Elektronika-u-Petnici/DC_load/README.md

# DC load

Petničko linearno opterećenje

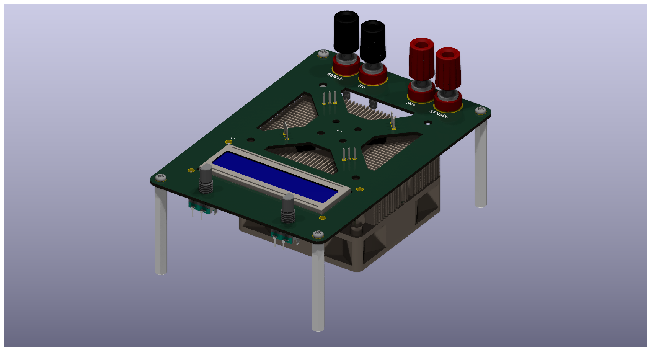
[picture p1: DC_load.png]
plot
