Elektronika-u-Petnici/DC_load/simulacije/UART_isolation.asc

C1: cap; 10µ
C2: cap; 100n
C3: cap; 10µ
C4: cap; 10µ
C5: cap; 100n
C6: cap; 10µ
C7: cap; 100n
C8: cap; 10µ
C9: cap; 10µ
C10: cap; 10µ
C11: cap; 10n
C12: cap; 10n
C13: cap; 10n
C14: cap; 10n
C15: cap; 10n
C16: cap; 10n
C17: cap; 10n
C18: cap; 10n
C19: cap; 1n
C20: cap; 10n
C21: cap; 1n
C22: cap; 10n
C23: cap; 1n
C24: cap; 10n
C25: cap; 1n
D1: diode; 1N4148
D2: diode; 1N4148
D3: diode; 1N4148
D4: diode; 1N4148
D5: diode; 1N4148
D6: diode; 1N4148
D7: diode; 1N4148
D8: diode; 1N4148
D9: diode; 1N4148
D10: diode; 1N4148
D11: diode; 1N4148
D12: diode; 1N4148
D13: diode; 1N4148
D14: diode; 1N4148
D15: diode; 1N4148
D16: diode; 1N4148
D17: diode; 1N4148
D18: diode; 1N4148
D19: diode; 1N4148
D20: diode; 1N4148
D21: diode; 1N4148
D22: diode; 1N4148
D23: diode; BAV99HM
D24: diode; BAV99HM
D25: diode; BAV99HM
D26: diode; BAV99HM
D27: diode; BAV99HM
D28: diode; BAV99HM
D29: diode; BAV99HM
D30: diode; BAV99HM
D31: diode; BAV99HM
D32: diode; BAV99HM
D33: diode; BAV99HM
D34: diode; 1N4148
D35: diode; BAV99HM
D36: diode; BAV99HM
D37: diode; BAV99HM
D38: diode; BAV99HM
D39: diode; BAV99HM
D40: diode; BAV99HM
D41: diode; BAV99HM
D42: diode; BAV99HM
D43: diode; BAV99HM
D44: diode; BAV99HM
D45: diode; BAV99HM
D46: diode; BAV99HM
D47: diode; BAV99HM
D48: diode; BAV99HM
D49: diode; BAV99HM
D50: diode; BAV99HM
D51: diode; BAV99HM
D52: diode; BAV99HM
D53: diode; BAV99HM
D54: diode; BAV99HM
D55: diode; BAV99HM
D56: diode; BAV99HM
D57: diode; BAV99HM
D58: diode; BAV99HM
D59: diode; BAV99HM
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
U23: PC817A
V1: voltage; 3.3V
V2: voltage; 12
V3: voltage; 5
V4: voltage; -5
V5: voltage; 24
V10: voltage; PULSE(5 0 0 10n 10n {0.5 / fsw} {1 / fsw})
Named nets: 12V, 0, 24V, 3V3, input, 5V, fault, TTL_OUT, output, output_3V3
.tran 0 55u 50u
.param vcc = 3.3
.param rin 1k
.param fsw = 115200 * 10
