Elektronika-u-Petnici/DC_load/simulacije/self_flyback_v5.asc

C1: cap; 100µ
C2: cap; 47n
C3: cap; 5µ
C4: cap; 4.7n
D1: schottky; 1N5819
D2: schottky; 1N5819
D3: schottky; 1N5819
D5: schottky; 1N5819
L1: ind2; {Lm}
L2: ind2; {Lm}
L3: ind2; {Lm}
L4: ind2; {Lm}
L5: ind; 100µ
Q1: npn; 2N5551
Q2: npn; 2N5551
Q3: npn; 2N5551
Q4: npn; 2N5551
Q5: npn; 2N5551
R1: res; 10k
R2: res; 100
R3: res; 10k
R4: res; 1k
R5: res; 1k
R6: res; {Rload}
R7: res; 100m
R8: res; 15k
R9: res; 2k
V1: voltage; 5
Named nets: 0, c
.tran 0 10000m 0 100n uic
K1 L1 L2 L3 L4 0.99
.param K = 1 Lm = 100u
.param Rload = 1000
