Elektronika-u-Petnici/DC_load/simulacije/DC_fan_isolator.asc

C1: cap; 1µ
C2: cap; 1µ
C3: cap; 1µ
I1: current; 500µ
I2: current; 1m
I3: current; 6m
Q1: npn; 2N3904
Q2: npn; 2N3904
Q3: npn; 2N3904
Q4: npn; 2N3904
Q5: npn; 2N3904
Q6: npn; 2N3904
Q7: pnp; 2N3906
Q8: pnp; 2N3906
Q9: npn; 2N3904
Q10: npn; 2N3904
Q11: npn; 2N5551
R1: res; 1k
R2: res; 100
R3: res; 100
R4: res; 1k
R5: res; 40k
R6: res; 33k
R7: res; 81k
R8: res; 22k
R9: res; 51k
R10: res; 10k
R11: res; 1k
R12: res; 510k
R13: res; 100k
R14: res; 1k
R15: res; 1k
R16: res; 100k
R17: res; 100k
R18: res; 1k
R19: res; 1m
R20: res; 10k
R21: res; 1m
R22: res; 30
R23: res; 1k
R24: res; 40k
R25: res; 10k
R26: res; 1m
R27: res; 10k
R28: res; 1k
R29: res; 300
U3: PC817A
V1: voltage; {Vbat}
V2: voltage; {Vbat}
V3: voltage; {Vbat}
V4: voltage; {Vbat}
V5: voltage; {Vbat}
V6: voltage; {Vbat}
V7: voltage; 12
V8: voltage; PULSE(5 0 0 10n 10n {0.5 / 30k} {1 / 30k})
Named nets: 0, vout+, input
.param fsw = 40k
.param d = 0.5
.param Cf = 10u
.tran 10m
.lib AO3400.mod
.step param Vbat list 3.5 3.9 4.2
