Elektronika-u-Petnici/DC_load/simulacije/inverter_PWM.asc

C1: cap; 100p
D1: diode; 1N4148
R2: res; 1Meg
R3: res; 100k
R6: res; 33k
U2: SN74HC14
V5: voltage; 3.6
Named nets: 0, out
.param fsw = 40k
.param d = 0.5
.param Cf = 10u
.tran 0 1m 0 1n uic
.ic V(out) = 3.6
