Elektronika-u-Petnici/DC_load/simulacije/gate_drive_v2.asc

C1: cap; 22µ
C2: cap; 22µ
C3: cap; 1n
C4: cap; 22µ
Q1: npn; 2N5550
Q2: pnp; 2N5401
Q3: npn; 2N5550
Q4: npn; 2N5550
Q5: pnp; 2N5401
Q6: npn; 2N5550
R1: res; 10m
R2: res; 10
R3: res; 10
R7: res; 1k
R8: res; 10m
R9: res; 1k
R14: res; 1k
R15: res; 1k
V1: voltage; 12
V2: voltage; PULSE(0 5 0 10n 10n {d / fsw} {1 / fsw})
V3: voltage; 5
V4: voltage; PULSE(0 5 {0.5 / fsw} 10n 10n {d / fsw} {1 / fsw})
Named nets: 0, G2, 5V, vin
.tran 10u uic
.param fsw = 200k
.param d = 0.5
.param Rload = 50
.param Lprim = 200u Lsec=200u
;tran 2m uic
