Elektronika-u-Petnici/DC_load/simulacije/half_bridge_pwm_gen_V3.asc

C5: cap; 100p
C6: cap; 100p
D3: schottky; 1N5819
D4: diode; 1N4148
D6: diode; 1N4148
Q1: npn; 2N5551
Q2: pnp; 2N5401
Q3: npn; 2N5551
R7: res; 1k
R9: res; 1k
R15: res; 1k
R16: res; 1k
U1: SN74HC14
U2: SN74HC14
U3: SN74HC14
U4: SN74HC14
U5: SN74HC14
V1: voltage; 12
V2: voltage; PULSE(0 12 0u 10n 10n {d / fsw} {1 / fsw})
V3: voltage; 5
Named nets: 0, G2, vin, 5V, G1
;tran 2m
.param fsw = 200k
.param d = 0.45
.param Rload = 50
.param Lprim = 200u Lsec=200u
.tran 2m uic
