Elektronika-u-Petnici/DC_load/simulacije/intentionally_disbalanced_half_bridge.asc

B1: bv; V= if(time >  start_time, idt(V(vout)*I(R30))/(time - start_time),0)
B2: bv; V=if(time > start_time, -idt(V(vin)*I(V1)) / (time - start_time),0)
B3: bv; V= min(max(V(output_power) / V(input_power),0), 1)
B4: bv; V=  V(input_power) - V(output_power)
C1: cap; 22µ
C2: cap; 22µ
C3: cap; 22µ
C4: cap; 22µ
C5: cap; 22µ
D1: schottky; 1N5819
D2: schottky; 1N5819
D3: schottky; 1N5819
L1: ind2; {Lprim}
L2: ind2; {Lsec}
L3: ind2; {Lprim}
L4: ind2; {Lsec}
L5: ind; 1µ
M1: nmos; AO6608_N
M2: nmos; AO6608_N
Q1: npn; 2N5551
Q2: pnp; 2N5401
Q3: npn; 2N5551
R1: res; 10m
R2: res; 10
R3: res; 10
R4: res; 1m
R5: res; 1m
R6: res; 10m
R7: res; 1k
R8: res; 10m
R9: res; 1k
R10: res; 1
R11: res; 1
R12: res; 1
R13: res; 1
R14: res; 10m
R30: res; 100
V1: voltage; 12
V2: voltage; PULSE(0 12 0.1u 10n 10n {d / fsw - 0.2u} {1 / fsw})
V3: voltage; 5
V4: voltage; PULSE(0 12 0 10n 10n {d / fsw} {1 / fsw})
Named nets: 0, G2, vin, vout, output_power, input_power, efficiency, losses, 5V
;tran 2m
.param fsw = 200k
.param d = 0.25
.param Rload = 50
.param Lprim = 200u Lsec=200u
.tran 2m uic
.param start_time = 1m
K1 L1 L2 L3 L4 0.999
