Elektronika-u-Petnici/DC_load/simulacije/DC_fan_boost.asc

C2: cap; 10µ
D1: schottky; 1N5819
L1: ind; 22µ
M1: nmos; AO4630_N
R1: res; 120
R2: res; 100m
R3: res; 40m
U3: SN74LVC1G08
U4: SN74LVC1G08
V1: voltage; PULSE(0 5 {1 / fsw / 2} 10n 10n {d / fsw} {1 / fsw})
V2: voltage; 310
V3: voltage; PULSE(0 5 10u 10n 10n 1m 10m)
V4: voltage; PULSE(0 12 10u 10n 10n 30u 10m 1)
V5: voltage; 5
Named nets: 0, 5V, input, source, init
.tran 10m
.param fsw = 100k
.param d = 0.3
