Elektronika-u-Petnici/DC_load/simulacije/3.3vzener_gate_drive_amp.asc

C1: cap; 100p
C2: cap; 10µ
D2: diode; BAV99HY
D3: diode; BAV99HY
Q1: pnp; 2N3906
Q2: npn; 2N5551
R1: res; 10k
R2: res; 10m
R3: res; 100
R4: res; 330
R5: res; 10k
R6: res; 100
R7: res; 1k
R8: res; 9k
R9: res; 1k
R10: res; 3k3
R11: res; 10k
U1: TLV9062
U2: opamp2; NCS21802
V1: voltage; 3.3
V2: voltage; 10
V3: voltage; SINE(0.5 0.1 10k)
V4: voltage; PULSE(12 13 0 10n 10n 10u 20u)
X1: n_channel_mosfet
Named nets: 0, 3V3, shunt, 12V
.tran 1m
.lib FQP6N90C.lib
.lib "NCS2180X SPICE MODEL.MOD"
