Elektronika-u-Petnici/DC_load/simulacije/12V_gate_drive.asc

C1: cap; 100p
R1: res; 10k
R2: res; 10m
R3: res; 1k
R4: res; 100
R5: res; 1k
U1: LM358
U2: opamp2; NCS21802
V1: voltage; 12
V2: voltage; 10
V3: voltage; SINE(0.5 0.1 10k)
V4: voltage; 5
X1: n_channel_mosfet
Named nets: 0, 12V, shunt, 5V
.tran 1m
.lib FQP6N90C.lib
.lib "NCS2180X SPICE MODEL.MOD"
