Elektronika-u-Petnici/DC_load/simulacije/ina181.asc

C1: cap; 100p
C3: cap; 100p
C4: cap; 10µ
D1: zener; BZX79C2V7
D5: zener; BZX79C2V7
D6: diode; 1N4148
D7: diode; 1N4148
Q2: pnp; 2N3906
R1: res; 1k
R2: res; 10m
R3: res; 100
R4: res; 9k
R5: res; 1k
R6: res; 2k
R10: res; 1k
R11: res; 10m
R12: res; 100
R13: res; 200
R14: res; 1k
R17: res; 9k
R18: res; 1k
U1: TLV9062
U2: INA181A1
U3: TLV9062
U5: INA181A1
V1: voltage; 5
V2: voltage; 10
V3: voltage; SINE(0.5 0.1 100k)
V4: voltage; 12
V6: voltage; 10
V7: voltage; SINE(0.5 0.1 100k)
X1: n_channel_mosfet
X2: n_channel_mosfet
Named nets: 5V, 0, 12V, shunt
.tran 1m
.lib FQP6N90C.lib
.lib "NCS2180X SPICE MODEL.MOD"
;tran 1m
.lib ina181a1.lib
;tran 1m
