Elektronika-u-Petnici/DC_load/simulacije/ncsc.asc

C3: cap; 100p
D4: zener; BZX79C2V7
R10: res; 10k
R11: res; 10m
R12: res; 100
R13: res; 100
R14: res; 1k
R15: res; 200
R16: res; 1k
R17: res; 9k
R18: res; 1k
U3: TLV9062
U4: opamp2; NCS21802
V1: voltage; 5
V4: voltage; 12
V6: voltage; 10
V7: voltage; SINE(0.5 0.1 100k)
X2: n_channel_mosfet
Named nets: 5V, 0, 12V
.tran 1m
.lib FQP6N90C.lib
.lib "NCS2180X SPICE MODEL.MOD"
;tran 1m
