Elektronika-u-Petnici/DC_load/simulacije/pnp_load.asc

B1: bv; V=100 * V(shunt)
C1: cap; 100p
Q1: npn; 2N3904
Q2: pnp; BD244C
R1: res; 10k
R2: res; 10m
R3: res; 100
R4: res; 100
R5: res; 600
U1: LM358
V1: voltage; 12
V2: voltage; 10
V3: voltage; SINE(0.5 0.1 10k)
V4: voltage; 5
Named nets: 0, 12V, shunt, 5V
.tran 1m
.lib FQP6N90C.lib
.lib "NCS2180X SPICE MODEL.MOD"
