Elektronika-u-Petnici/DC_load/simulacije/zener_gate_drive.asc

B1: bv; V=100 * V(shunt)
C1: cap; 100p
D1: zener; BZX79C2V7
R1: res; 10k
R2: res; 10m
R3: res; 100
R4: res; 10k
U1: TLV9062
V1: voltage; 5
V2: voltage; 10
V3: voltage; SINE(0.5 0.1 10k)
V4: voltage; 12
X1: n_channel_mosfet
Named nets: 0, 5V, shunt, 12V
.tran 1m
.lib FQP6N90C.lib
