Elektronika-u-Petnici/DC_load/simulacije/zener_gate_drive_amp.asc

C1: cap; 100p
C2: cap; 10µ
C3: cap; 100p
D1: zener; BZX79C2V7
D2: diode; 1N4148
D3: diode; 1N4148
D4: zener; BZX79C2V7
Q1: pnp; 2N3906
R1: res; 10k
R2: res; 10m
R3: res; 100
R4: res; 200
R5: res; 1k
R6: res; 100
R7: res; 1k
R8: res; 9k
R9: res; 1k
R10: res; 10k
R11: res; 10m
R12: res; 100
R13: res; 100
R14: res; 1k
R15: res; 200
R16: res; 1k
R17: res; 9k
R18: res; 1k
U1: TLV9062
U2: opamp2; NCS21802
U3: TLV9062
U4: opamp2; NCS21802
V1: voltage; 5
V2: voltage; 10
V3: voltage; SINE(0.5 0.1 10k)
V4: voltage; 12
V6: voltage; 10
V7: voltage; SINE(0.5 0.1 10k)
X1: n_channel_mosfet
X2: n_channel_mosfet
Named nets: 0, 5V, shunt, 12V
.tran 1m
.lib FQP6N90C.lib
.lib "NCS2180X SPICE MODEL.MOD"
;tran 1m
