Elektronika-u-Petnici/DC_load/simulacije/voltage_reference.asc

C1: cap; 10µ
C3: cap; 10µ
C4: cap; 10µ
C6: cap; 100µ
C7: cap; 10µ
C8: cap; 100µ
C9: cap; 10µ
C10: cap; 100µ
D1: diode; 1N4148
D2: diode; 1N4148
I1: current; SINE(2m 1m 200k)
I2: current; SINE(2m 1m 200k)
I3: current; SINE(2m 1m 200k)
Q2: pnp; 2N3906
Q3: npn; 2N3904
R1: res; 1k
R2: res; 200
R3: res; {p}
R4: res; 100k
R5: res; 100k
R6: res; 100k
R7: res; 100k
U1: TL431
U2: TL431
U3: TL431
V1: voltage; SINE(5 1 100k)
Named nets: 0
.tran 5m
.step param p list 2k 5k 10k
