Elektronika-u-Petnici/DC_load/kicad/DC_load_isolation_module/DC_load_isolation_module.kicad_pcb

## KiCad design kicad/DC_load_isolation_module/DC_load_isolation_module.kicad_pcb (2026-01-17)

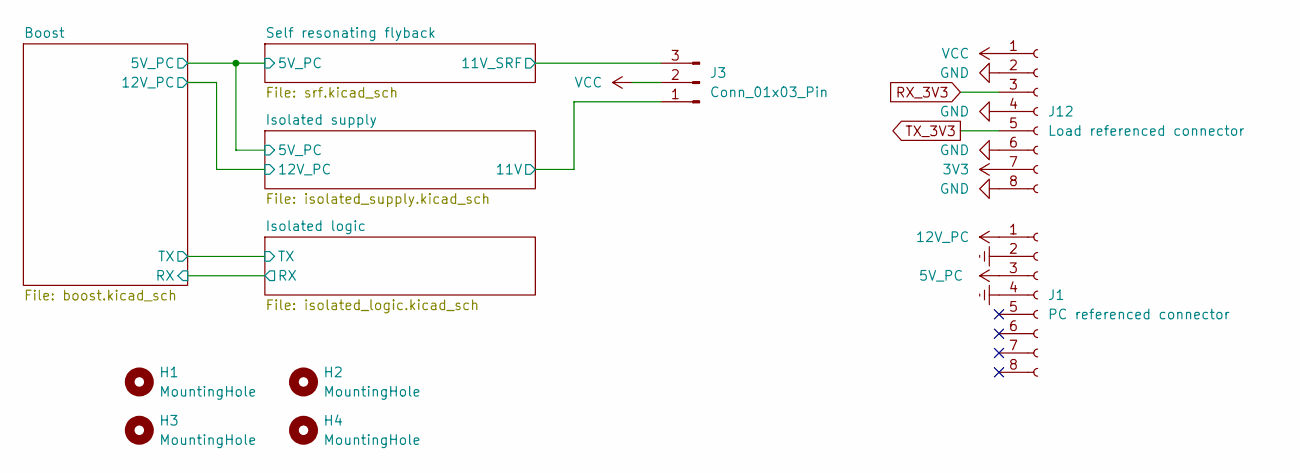
[picture p2: schematic DC_load_isolation_module.kicad_sch, DC load isolation module]

Parts:
H1, H2, H3, H4: MountingHole; M3_hole_with_spacer
J1: PC referenced connector; PinSocket_1x08_P2.54mm_Vertical
J3: Conn_01x03_Pin; PinHeader_1x03_P2.54mm_Vertical
J12: Load referenced connector; PinSocket_1x08_P2.54mm_Vertical

Connections:
3V3: J12.7; also elsewhere on the board
5V_PC: J1.3; also elsewhere on the board
12V_PC: J1.1; also elsewhere on the board
/Isolated supply/11V: J3.1; also elsewhere on the board
/Self resonating flyback/11V_SRF: J3.3; also elsewhere on the board
Earth: J1.2, J1.4; also elsewhere on the board
GND: J12.2, J12.4, J12.6, J12.8; also elsewhere on the board
RX_3V3: J12.3; also elsewhere on the board
TX_3V3: J12.5; also elsewhere on the board
VCC: J3.2, J12.1

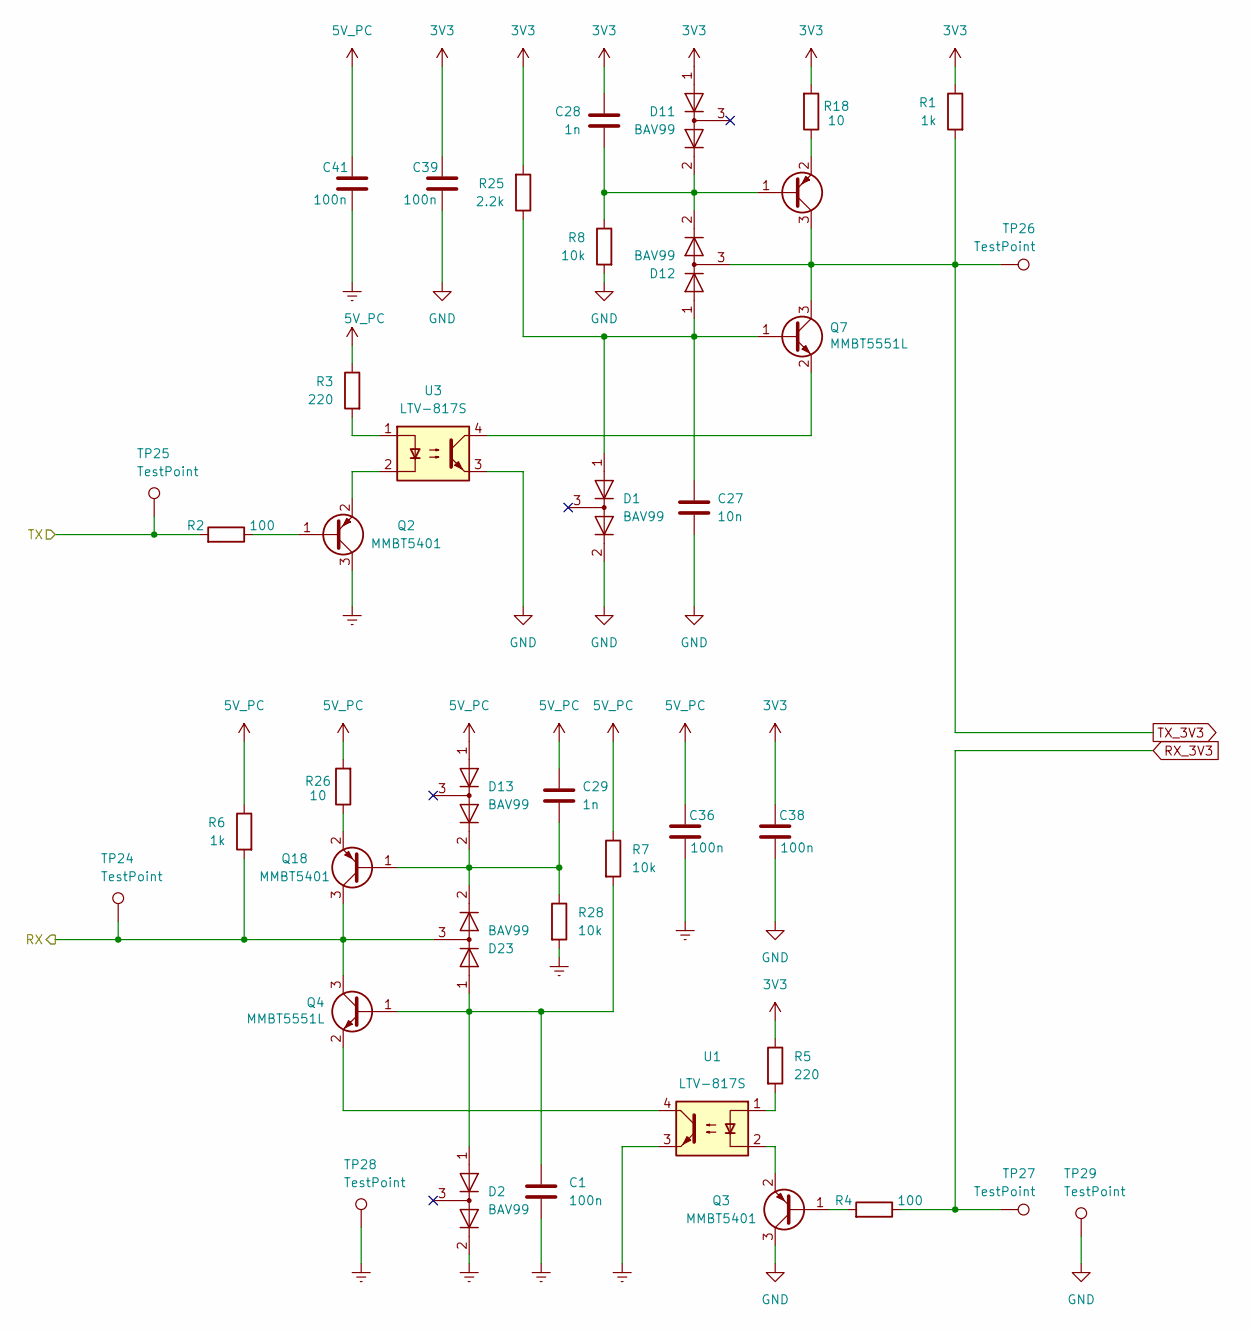
[picture p3: schematic isolated_logic.kicad_sch]

Parts:
C1, C36, C38, C39, C41: 100n; C_0603_1608Metric_Pad1.08x0.95mm_HandSolder; LCSC C14663
C27: 10n; C_0603_1608Metric_Pad1.08x0.95mm_HandSolder; LCSC C57112
C28, C29: 1n; C_0603_1608Metric_Pad1.08x0.95mm_HandSolder; LCSC C1588
D1, D2, D11, D12, D13, D23: BAV99; SOT-23; LCSC C2500
Q2, Q3, Q17, Q18: MMBT5401; SOT-23; LCSC C8326
Q4, Q7: MMBT5551L; SOT-23; LCSC C2145
R1, R6: 1k; R_0603_1608Metric_Pad0.98x0.95mm_HandSolder; LCSC C22962
R2, R4: 100; R_0603_1608Metric_Pad0.98x0.95mm_HandSolder; LCSC C22775
R3, R5: 220; R_0603_1608Metric_Pad0.98x0.95mm_HandSolder; LCSC C22962
R7, R8, R28: 10k; R_0603_1608Metric_Pad0.98x0.95mm_HandSolder; LCSC C25804
R18, R26: 10; R_0603_1608Metric_Pad0.98x0.95mm_HandSolder; LCSC C22859
R25: 2.2k; R_0603_1608Metric_Pad0.98x0.95mm_HandSolder; LCSC C4190
TP24, TP25, TP26, TP27, TP28, TP29: TestPoint; TestPoint_Pad_D2.0mm
U1, U3: LTV-817S; SMDIP-4_W9.53mm

Connections:
3V3: C28.2, C38.1, C39.1, D11.1 (K), R1.1, R5.1, R18.2, R25.2; also elsewhere on the board
5V_PC: C29.2, C36.1, C41.1, D13.1 (K), R3.1, R6.1, R7.1, R26.2; also elsewhere on the board
/Boost/RX: D23.3 (K), Q4.3 (C), Q18.3 (C), R6.2, TP24.1; also elsewhere on the board
/Boost/TX: R2.2, TP25.1; also elsewhere on the board
Earth: C1.1, C36.2, C41.2, D2.2 (A), Q2.3 (C), R28.2, TP28.1, U1.3; also elsewhere on the board
GND: C27.1, C38.2, C39.2, D1.2 (A), Q3.3 (C), R8.2, TP29.1, U3.3; also elsewhere on the board
unnamed: C28.1, D11.2 (A), D12.2 (A), Q17.1 (B), R8.1
unnamed: C29.1, D13.2 (A), D23.2 (A), Q18.1 (B), R28.1
unnamed: Q2.1 (B), R2.1
unnamed: Q2.2 (E), U3.2
unnamed: Q3.1 (B), R4.2
unnamed: Q3.2 (E), U1.2
unnamed: C1.2, D2.1 (K), D23.1 (K), Q4.1 (B), R7.2
unnamed: Q4.2 (E), U1.4
unnamed: C27.2, D1.1 (K), D12.1 (K), Q7.1 (B), R25.1
unnamed: Q7.2 (E), U3.4
unnamed: Q17.2 (E), R18.1
unnamed: Q18.2 (E), R26.1
unnamed: R3.2, U3.1
unnamed: R5.2, U1.1
RX_3V3: R4.1, TP27.1; also elsewhere on the board
TX_3V3: D12.3 (K), Q7.3 (C), Q17.3 (C), R1.2, TP26.1; also elsewhere on the board

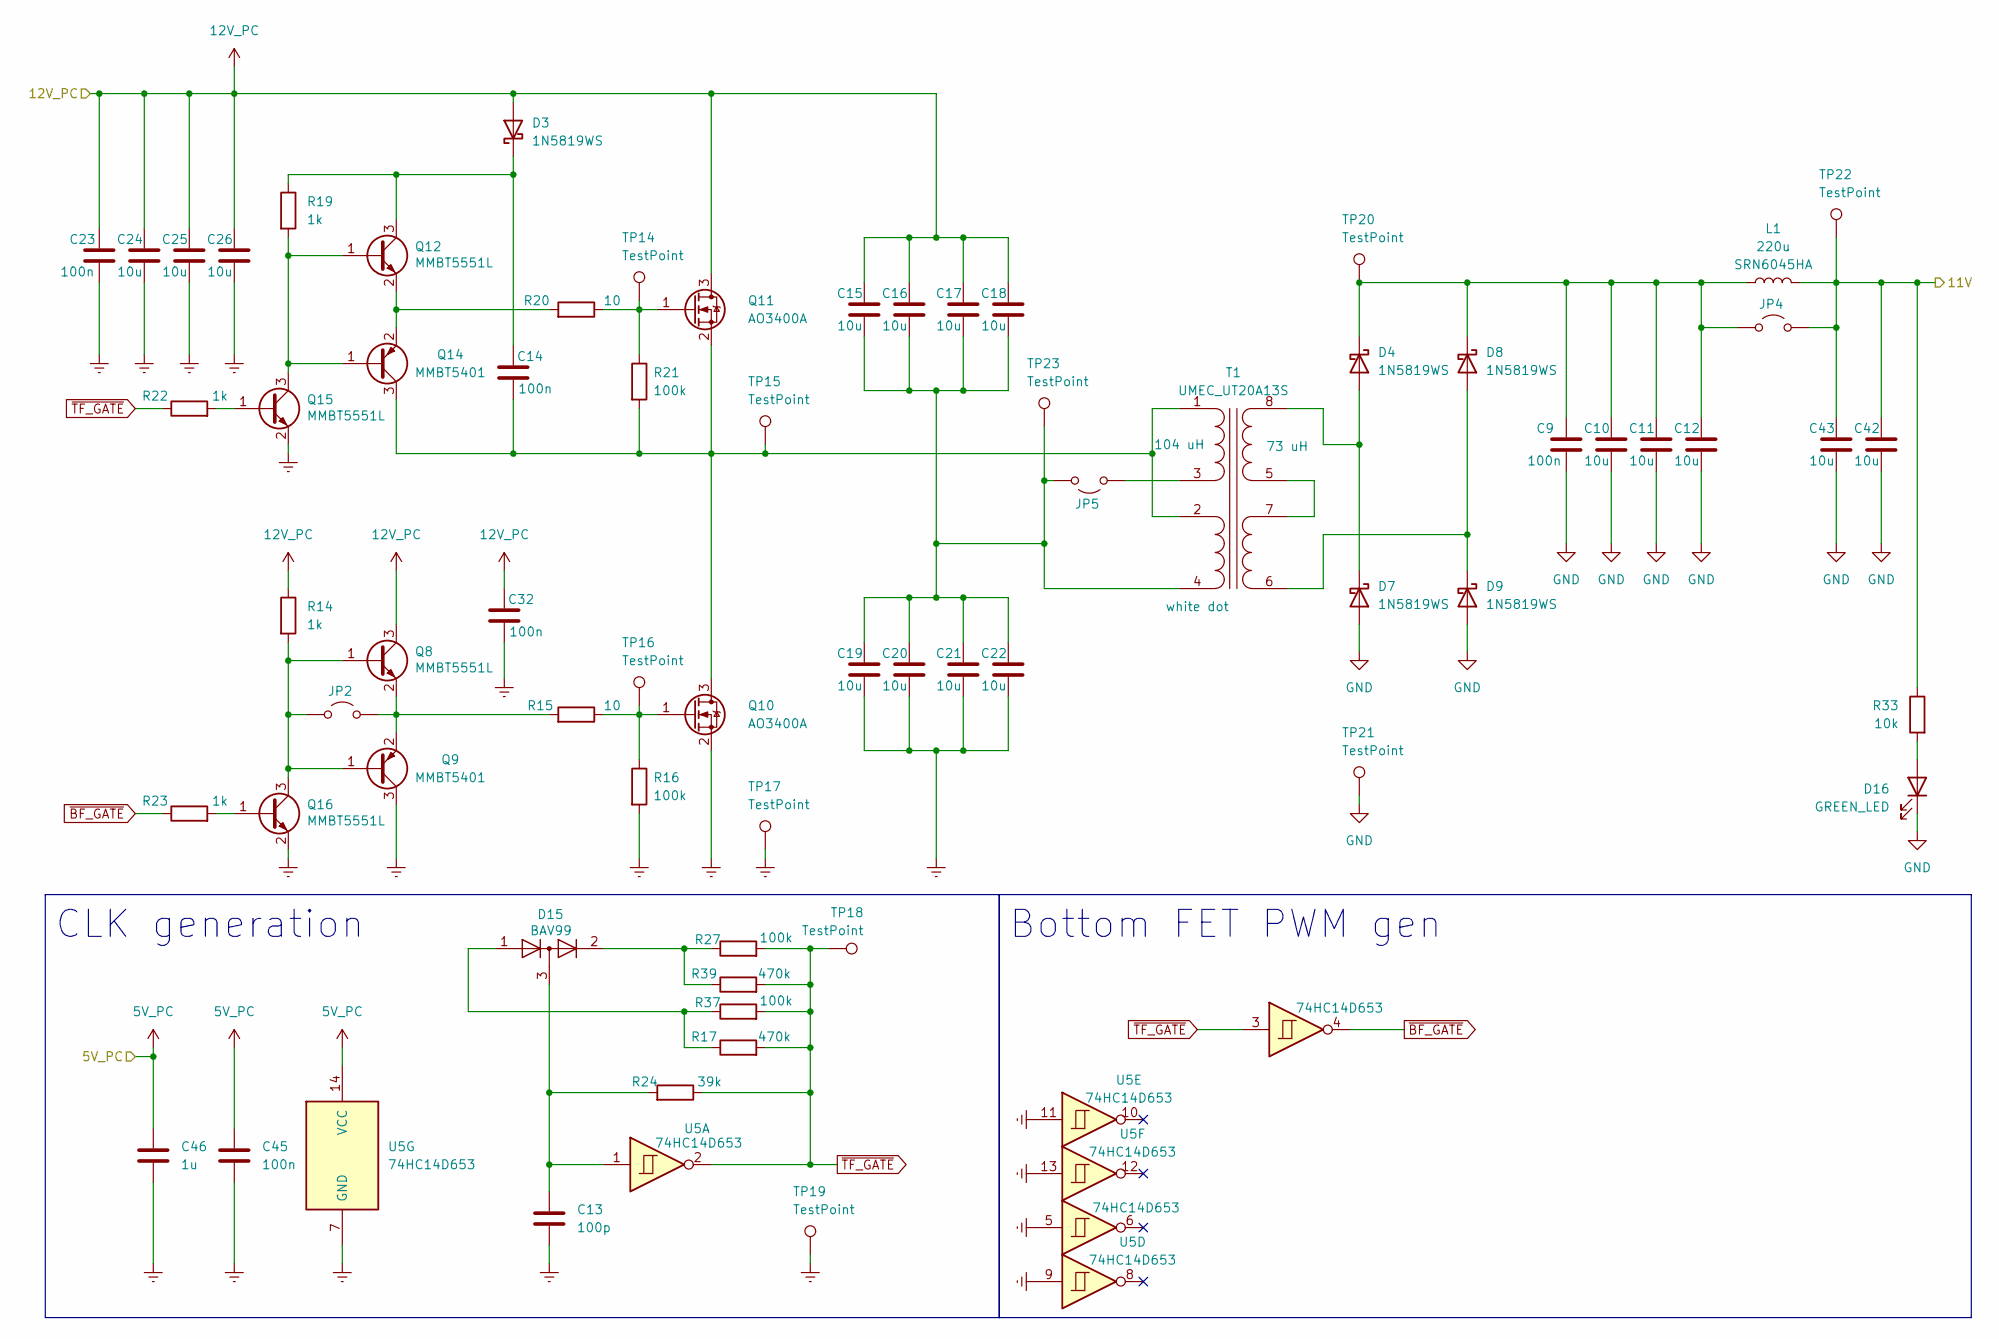
[picture p4: schematic isolated_supply.kicad_sch]

Parts:
C9, C14, C23, C32, C45: 100n; C_0603_1608Metric_Pad1.08x0.95mm_HandSolder; LCSC C14663
C10, C11, C12, C15, C16, C17, C18, C19, C20, C21, C22, C24, C25, C26, C42, C43: 10u; C_0603_1608Metric_Pad1.08x0.95mm_HandSolder; LCSC C96446
C13: 100p; C_0603_1608Metric_Pad1.08x0.95mm_HandSolder; LCSC C14858
C46: 1u; C_0603_1608Metric_Pad1.08x0.95mm_HandSolder; LCSC C15849
D3, D4, D7, D8, D9: 1N5819WS; D_SOD-323; LCSC C191023
D15: BAV99; SOT-23; LCSC C2500
D16: GREEN_LED; LED_0805_2012Metric_Pad1.15x1.40mm_HandSolder; LCSC C2297
JP2, JP4, JP5: Jumper_2_Open; SolderJumper-2_P1.3mm_Open_RoundedPad1.0x1.5mm
L1: 220u; L_Bourns_SRN6045TA; Partname SRN6045HA
Q8, Q12, Q15, Q16: MMBT5551L; SOT-23; LCSC C2145
Q9, Q14: MMBT5401; SOT-23; LCSC C8326
Q10, Q11: AO3400A; SOT-23; LCSC C20917
R14, R19, R22, R23: 1k; R_0603_1608Metric_Pad0.98x0.95mm_HandSolder; LCSC C22962
R15, R20: 10; R_0603_1608Metric_Pad0.98x0.95mm_HandSolder; LCSC C22859
R16, R21, R27, R37: 100k; R_0603_1608Metric_Pad0.98x0.95mm_HandSolder; LCSC C25803
R17, R39: 470k; R_0603_1608Metric_Pad0.98x0.95mm_HandSolder; LCSC C23178
R24: 39k; R_0603_1608Metric_Pad0.98x0.95mm_HandSolder; LCSC C23153
R33: 10k; R_0603_1608Metric_Pad0.98x0.95mm_HandSolder; LCSC C25804
T1: UMEC_UT20A13S
TP14, TP15, TP16, TP17, TP18, TP19, TP20, TP21, TP22, TP23: TestPoint; TestPoint_Pad_D2.0mm
U5: 74HC14D653; SOIC-14_3.9x8.7mm_P1.27mm; LCSC C5605

Connections:
5V_PC: C45.2, C46.2, U5.14 (VCC); also elsewhere on the board
12V_PC: C15.1, C16.1, C17.1, C18.1, C23.1, C24.1, C25.1, C26.1, C32.1, D3.2 (A), Q8.3 (C), Q11.3 (D), R14.1; also elsewhere on the board
/Isolated supply/11V: C42.1, C43.1, JP4.2 (B), L1.2, R33.1, TP22.1; also elsewhere on the board
Earth: C13.1, C19.2, C20.2, C21.2, C22.2, C23.2, C24.2, C25.2, C26.2, C32.2, C45.1, C46.1, Q9.3 (C), Q10.2 (S), Q15.2 (E), Q16.2 (E), R16.2, TP17.1, TP19.1, U5.5, U5.7 (GND), U5.9, U5.11, U5.13; also elsewhere on the board
GND: C9.2, C10.2, C11.2, C12.2, C42.2, C43.2, D7.2 (A), D9.2 (A), D16.1 (K), TP21.1; also elsewhere on the board
unnamed: C13.2, D15.3 (K), R24.2, U5.1
unnamed: C14.1, D3.1 (K), Q12.3 (C), R19.1
unnamed: D4.2 (A), D7.1 (K), T1.8 (SB)
unnamed: C9.1, C10.1, C11.1, C12.1, D4.1 (K), D8.1 (K), JP4.1 (A), L1.1, TP20.1
unnamed: D8.2 (A), D9.1 (K), T1.6 (SA)
unnamed: D15.2 (A), R27.1, R39.1
unnamed: D15.1 (K), R17.1, R37.1
unnamed: D16.2 (A), R33.2
unnamed: JP2.1 (A), Q8.1 (B), Q9.1 (B), Q16.3 (C), R14.2
unnamed: JP2.2 (B), Q8.2 (E), Q9.2 (E), R15.2
unnamed: C15.2, C16.2, C17.2, C18.2, C19.1, C20.1, C21.1, C22.1, JP5.1 (A), T1.4 (AB), TP23.1
unnamed: JP5.2 (B), T1.3 (AB)
unnamed: C14.2, Q10.3 (D), Q11.2 (S), Q14.3 (C), R21.2, T1.1 (AA), T1.2 (AA), TP15.1
unnamed: Q10.1 (G), R15.1, R16.1, TP16.1
unnamed: Q11.1 (G), R20.1, R21.1, TP14.1
unnamed: Q12.1 (B), Q14.1 (B), Q15.3 (C), R19.2
unnamed: Q12.2 (E), Q14.2 (E), R20.2
unnamed: Q15.1 (B), R22.2
unnamed: Q16.1 (B), R23.2
unnamed: T1.5 (SA), T1.7 (SB)
~BF_GATE: R23.1, U5.4
~TF_GATE: R17.2, R22.1, R24.1, R27.2, R37.2, R39.2, TP18.1, U5.2, U5.3

Notes on the sheet:
Bottom FET PWM gen
CLK generation

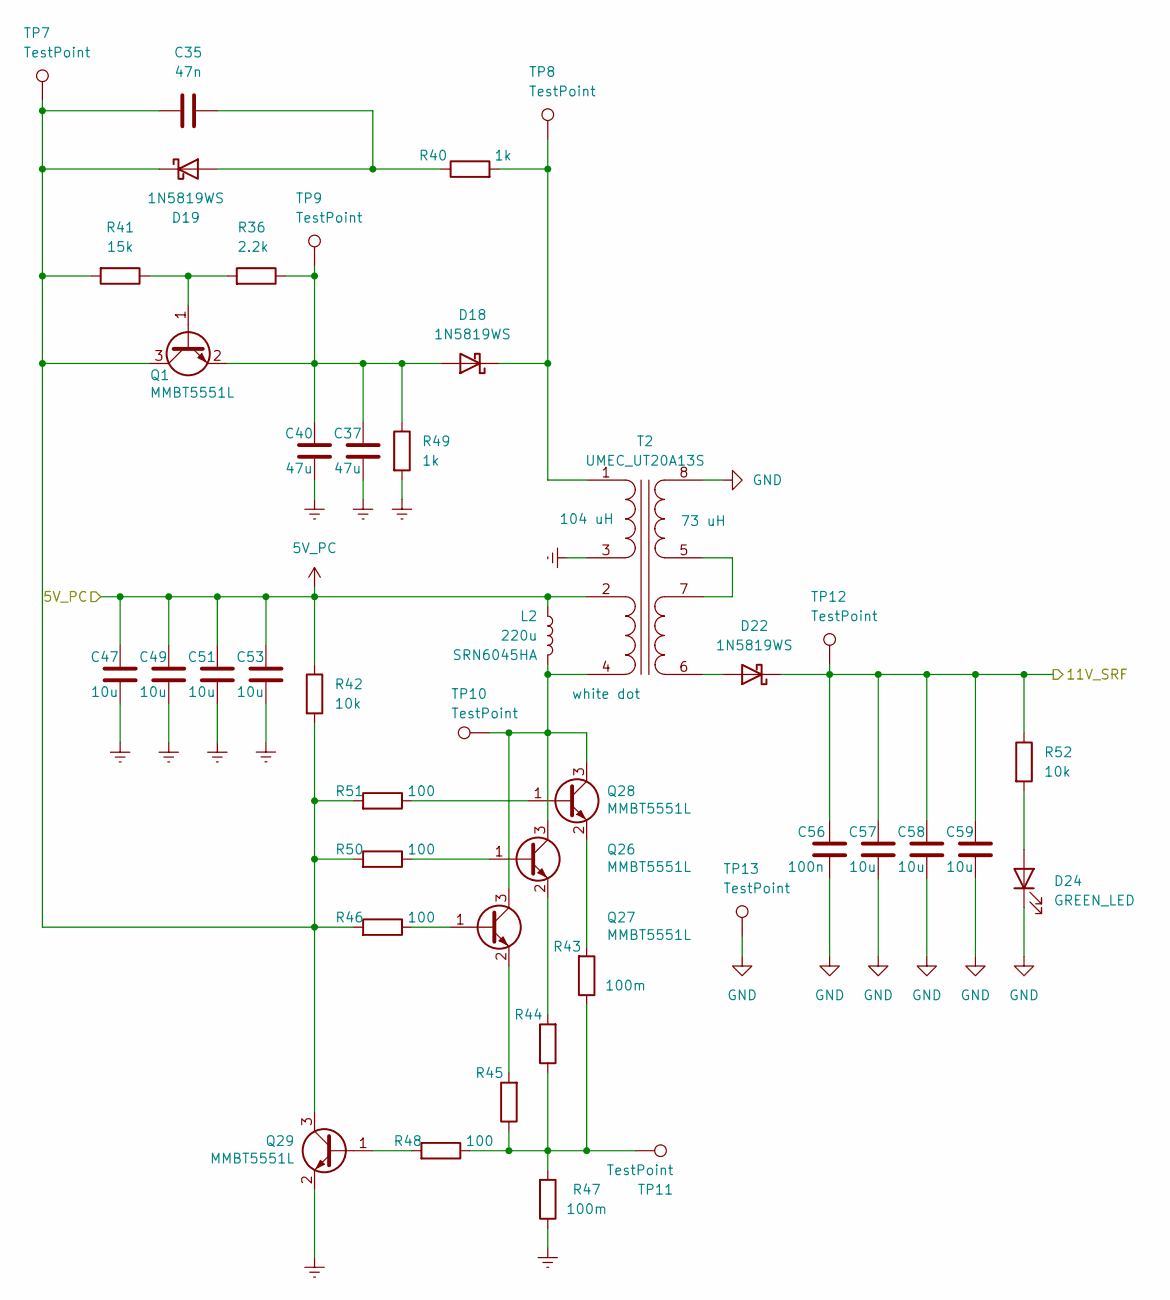
[picture p5: schematic srf.kicad_sch]

Parts:
C35: 47n; C_0603_1608Metric_Pad1.08x0.95mm_HandSolder; LCSC C1622
C37, C40: 47u; C_1206_3216Metric_Pad1.33x1.80mm_HandSolder; LCSC C96123
C47, C49, C51, C53, C57, C58, C59: 10u; C_0603_1608Metric_Pad1.08x0.95mm_HandSolder; LCSC C96446
C56: 100n; C_0603_1608Metric_Pad1.08x0.95mm_HandSolder; LCSC C14663
D18, D19, D22: 1N5819WS; D_SOD-323; LCSC C191023
D24: GREEN_LED; LED_0805_2012Metric_Pad1.15x1.40mm_HandSolder; LCSC C2297
L2: 220u; L_Bourns_SRN6045TA; Partname SRN6045HA
Q1, Q26, Q27, Q28, Q29: MMBT5551L; SOT-23; LCSC C2145
R36: 2.2k; R_0603_1608Metric_Pad0.98x0.95mm_HandSolder; LCSC C4190
R40, R49: 1k; R_0603_1608Metric_Pad0.98x0.95mm_HandSolder; LCSC C22962
R41: 15k; R_0603_1608Metric_Pad0.98x0.95mm_HandSolder; LCSC C22809
R42, R52: 10k; R_0603_1608Metric_Pad0.98x0.95mm_HandSolder; LCSC C25804
R43, R44, R45, R47: 100m; R_1206_3216Metric_Pad1.30x1.75mm_HandSolder; LCSC C25334
R46, R48, R50, R51: 100; R_0603_1608Metric_Pad0.98x0.95mm_HandSolder; LCSC C22775
T2: UMEC_UT20A13S
TP7, TP8, TP9, TP10, TP11, TP12, TP13: TestPoint; TestPoint_Pad_D2.0mm

Connections:
5V_PC: C47.1, C49.1, C51.1, C53.1, L2.2, R42.1, T2.2 (AA); also elsewhere on the board
/Self resonating flyback/11V_SRF: C56.1, C57.1, C58.1, C59.1, D22.1 (K), R52.1, TP12.1; also elsewhere on the board
Earth: C37.2, C40.2, C47.2, C49.2, C51.2, C53.2, Q29.2 (E), R47.1, R49.2, T2.3 (AB); also elsewhere on the board
GND: C56.2, C57.2, C58.2, C59.2, D24.1 (K), T2.8 (SB), TP13.1; also elsewhere on the board
unnamed: C37.1, C40.1, D18.2 (A), Q1.2 (E), R36.1, R49.1, TP9.1
unnamed: D18.1 (K), R40.2, T2.1 (AA), TP8.1
unnamed: C35.2, D19.2 (A), R40.1
unnamed: C35.1, D19.1 (K), Q1.3 (C), Q29.3 (C), R41.2, R42.2, R46.2, R50.2, R51.2, TP7.1
unnamed: D22.2 (A), T2.6 (SA)
unnamed: D24.2 (A), R52.2
unnamed: Q1.1 (B), R36.2, R41.1
unnamed: Q26.1 (B), R50.1
unnamed: L2.1, Q26.3 (C), Q27.3 (C), Q28.3 (C), T2.4 (AB), TP10.1
unnamed: Q26.2 (E), R44.2
unnamed: Q27.1 (B), R46.1
unnamed: Q27.2 (E), R45.2
unnamed: Q28.1 (B), R51.1
unnamed: Q28.2 (E), R43.2
unnamed: Q29.1 (B), R48.2
unnamed: R43.1, R44.1, R45.1, R47.2, R48.1, TP11.1
unnamed: T2.5 (SA), T2.7 (SB)

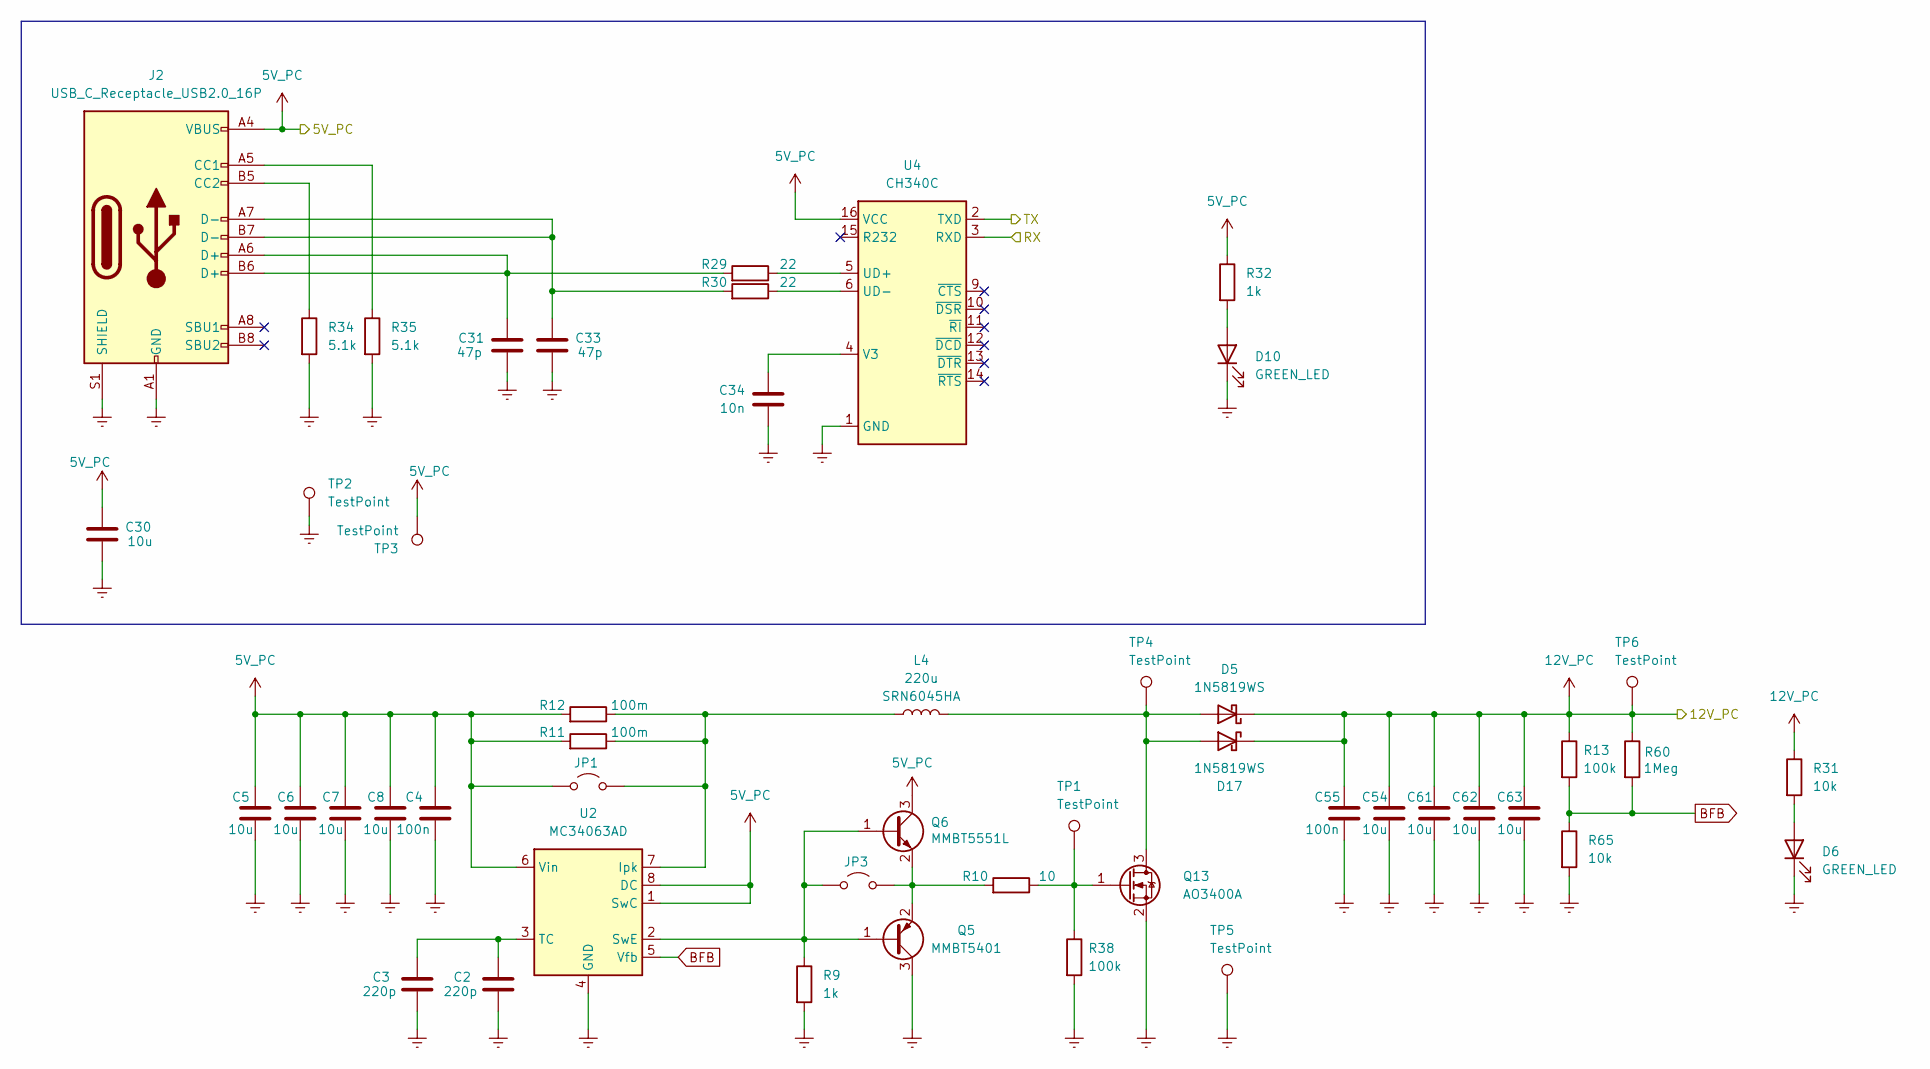
[picture p6: schematic boost.kicad_sch]

Parts:
C2, C3: 220p; C_0603_1608Metric_Pad1.08x0.95mm_HandSolder; LCSC C1603
C4, C55: 100n; C_0603_1608Metric_Pad1.08x0.95mm_HandSolder; LCSC C14663
C5, C6, C7, C8, C30, C54, C61, C62, C63: 10u; C_0603_1608Metric_Pad1.08x0.95mm_HandSolder; LCSC C96446
C31, C33: 47p; C_0603_1608Metric_Pad1.08x0.95mm_HandSolder; LCSC C1671
C34: 10n; C_0603_1608Metric_Pad1.08x0.95mm_HandSolder; LCSC C57112
D5, D17: 1N5819WS; D_SOD-323; LCSC C191023
D6, D10: GREEN_LED; LED_0805_2012Metric_Pad1.15x1.40mm_HandSolder; LCSC C2297
J2: USB_C_Receptacle_USB2.0_16P; USB_C_Receptacle_G-Switch_GT-USB-7010ASV
JP1, JP3: Jumper_2_Open; SolderJumper-2_P1.3mm_Open_RoundedPad1.0x1.5mm
L4: 220u; L_Bourns_SRN6045TA; Partname SRN6045HA
Q5: MMBT5401; SOT-23; LCSC C8326
Q6: MMBT5551L; SOT-23; LCSC C2145
Q13: AO3400A; SOT-23; LCSC C20917
R9, R32: 1k; R_0603_1608Metric_Pad0.98x0.95mm_HandSolder; LCSC C22962
R10: 10; R_0603_1608Metric_Pad0.98x0.95mm_HandSolder; LCSC C22859
R11, R12: 100m; R_1206_3216Metric_Pad1.30x1.75mm_HandSolder; LCSC C25334
R13, R38: 100k; R_0603_1608Metric_Pad0.98x0.95mm_HandSolder; LCSC C25803
R29, R30: 22; R_0603_1608Metric_Pad0.98x0.95mm_HandSolder; LCSC C23345
R31, R65: 10k; R_0603_1608Metric_Pad0.98x0.95mm_HandSolder; LCSC C25804
R34, R35: 5.1k; R_0603_1608Metric_Pad0.98x0.95mm_HandSolder; LCSC C23186
R60: 1Meg; R_0603_1608Metric_Pad0.98x0.95mm_HandSolder; LCSC C22935
TP1, TP2, TP3, TP4, TP5, TP6: TestPoint; TestPoint_Pad_D2.0mm
U2: MC34063AD; SOIC-8_3.9x4.9mm_P1.27mm
U4: CH340C; SOIC-16_3.9x9.9mm_P1.27mm

Connections:
5V_PC: C4.1, C5.1, C6.1, C7.1, C8.1, C30.1, J2.A4 (VBUS), J2.A9 (VBUS), J2.B4 (VBUS), J2.B9 (VBUS), JP1.1 (A), Q6.3 (C), R11.2, R12.2, R32.1, TP3.1, U2.1 (SwC), U2.6 (Vin), U2.8 (DC), U4.16 (VCC); also elsewhere on the board
12V_PC: C54.1, C55.1, C61.1, C62.1, C63.1, D5.1 (K), D17.1 (K), R13.1, R31.1, R60.1, TP6.1; also elsewhere on the board
/Boost/RX: U4.3 (RXD); also elsewhere on the board
/Boost/TX: U4.2 (TXD); also elsewhere on the board
BFB: R13.2, R60.2, R65.1, U2.5 (Vfb)
Earth: C2.2, C3.2, C4.2, C5.2, C6.2, C7.2, C8.2, C30.2, C31.2, C33.2, C34.1, C54.2, C55.2, C61.2, C62.2, C63.2, D6.1 (K), D10.1 (K), J2.A1 (GND), J2.A12 (GND), J2.B1 (GND), J2.B12 (GND), J2.S1 (SHIELD), Q5.3 (C), Q13.2 (S), R9.2, R34.2, R35.2, R38.2, R65.2, TP2.1, TP5.1, U2.4 (GND), U4.1 (GND); also elsewhere on the board
unnamed: C31.1, J2.A6 (D+), J2.B6 (D+), R29.2
unnamed: C33.1, J2.A7 (D-), J2.B7 (D-), R30.2
unnamed: D6.2 (A), R31.2
unnamed: D10.2 (A), R32.2
unnamed: D5.2 (A), D17.2 (A), L4.2, Q13.3 (D), TP4.1
unnamed: J2.A5 (CC1), R35.1
unnamed: J2.B5 (CC2), R34.1
unnamed: JP1.2 (B), L4.1, R11.1, R12.1, U2.7 (Ipk)
unnamed: JP3.1 (A), Q5.1 (B), Q6.1 (B), R9.1, U2.2 (SwE)
unnamed: JP3.2 (B), Q5.2 (E), Q6.2 (E), R10.2
unnamed: Q13.1 (G), R10.1, R38.1, TP1.1
unnamed: C2.1, C3.1, U2.3 (TC)
unnamed: R29.1, U4.5 (UD+)
unnamed: R30.1, U4.6 (UD-)
unnamed: C34.2, U4.4 (V3)

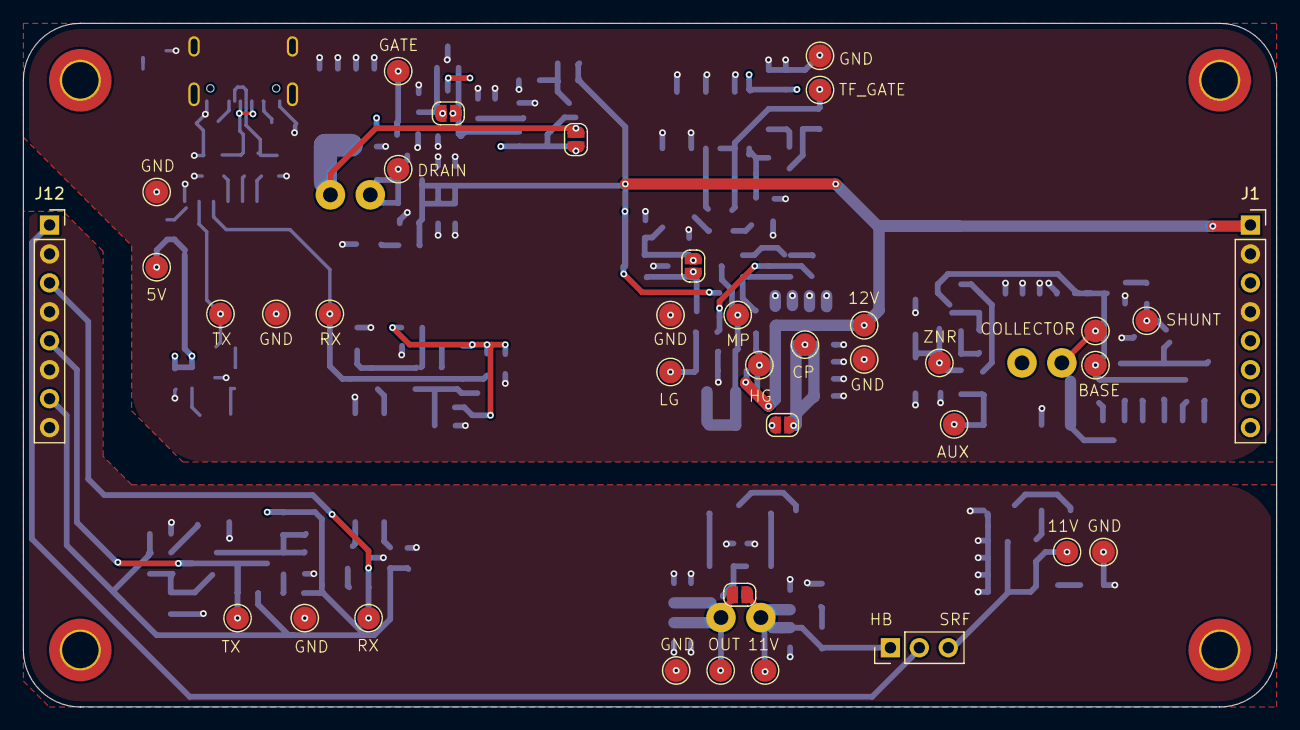
[picture p7: board DC_load_isolation_module.kicad_pcb from above]

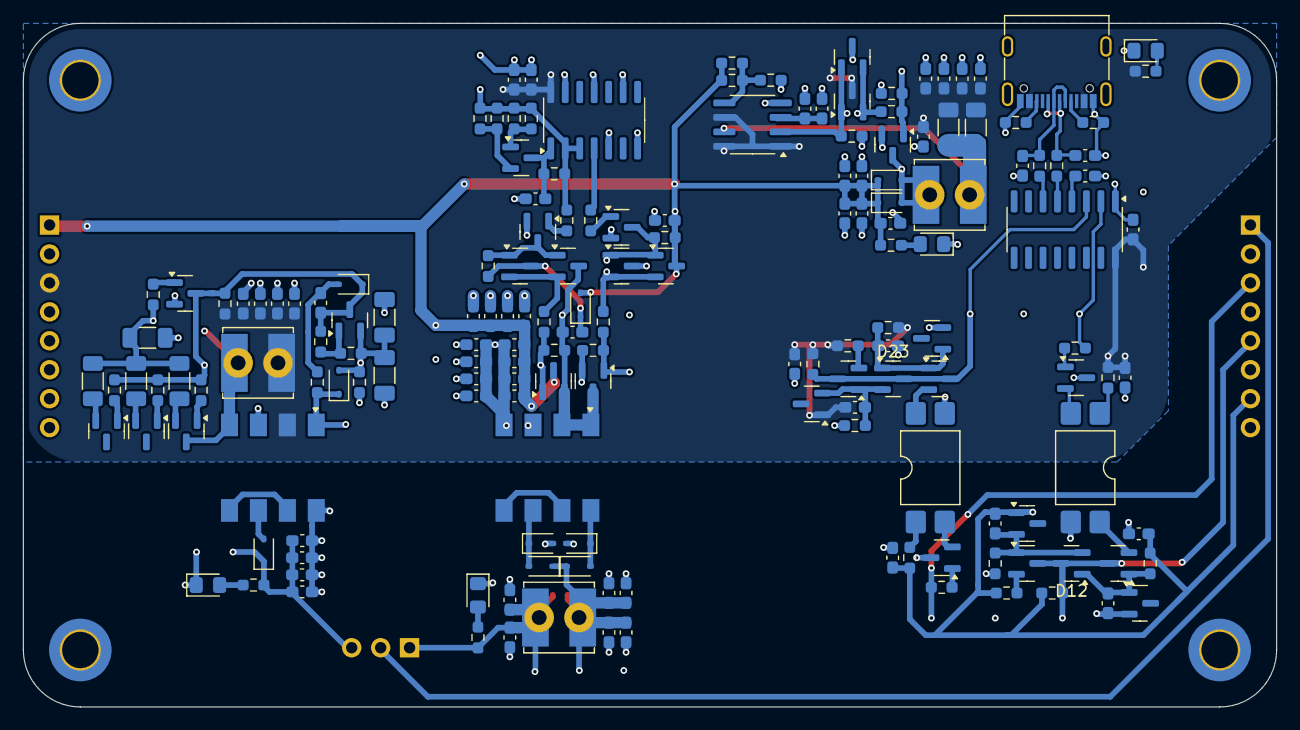
[picture p8: board DC_load_isolation_module.kicad_pcb from below]

Board: 2 copper layers, 110.0 x 60.0 mm, 207 parts (166 on the bottom side), 81 nets.
