Elektronika-u-Petnici/DC_load/kicad/DC_load/DC_load.kicad_pcb

## KiCad design kicad/DC_load/DC_load.kicad_pcb (2026-01-17)

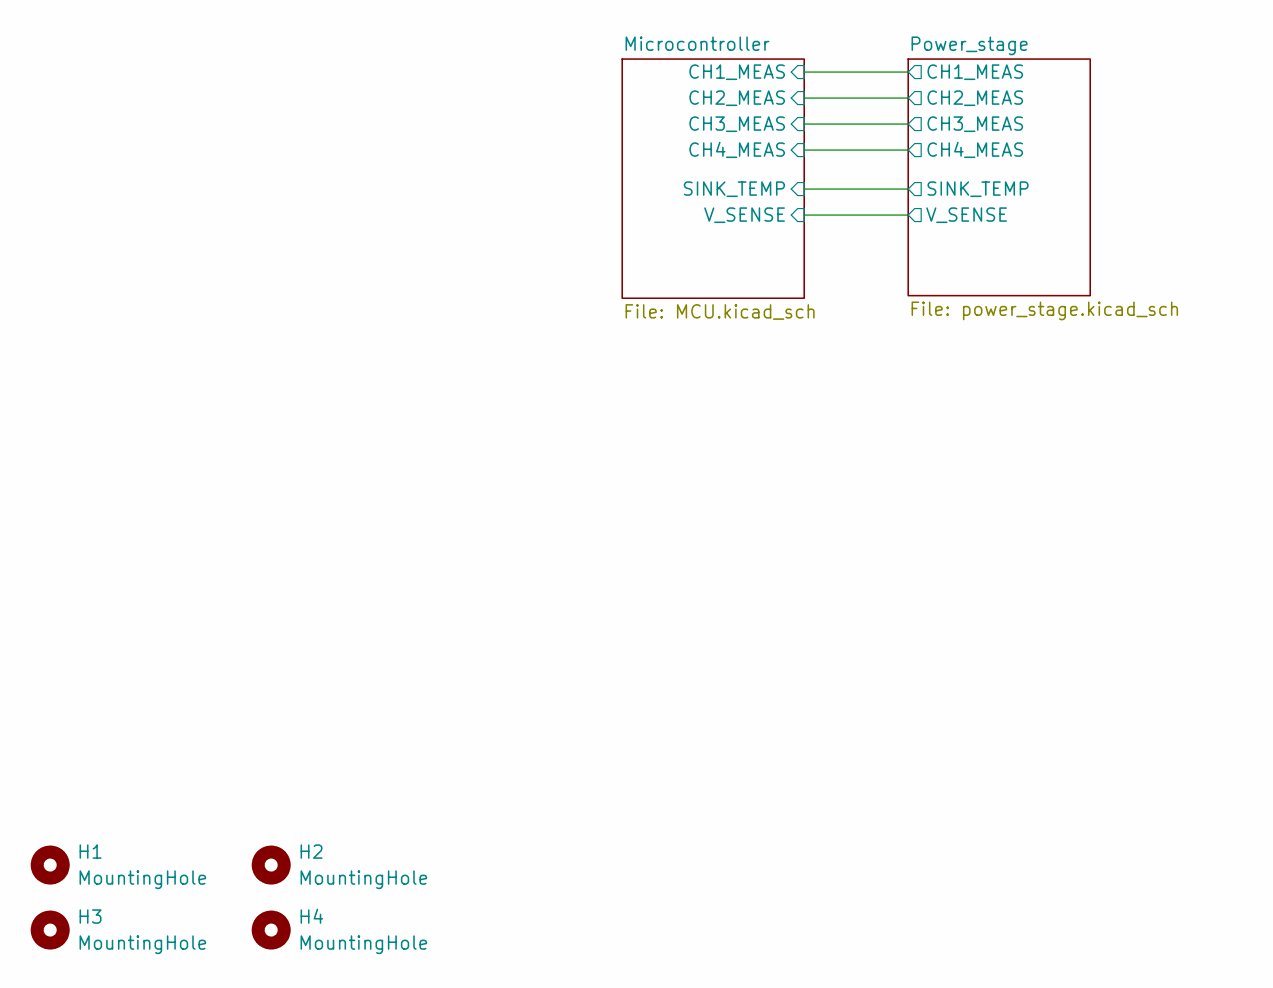
[picture p9: schematic DC_load.kicad_sch, DC load]

Parts:
H1, H2, H3, H4: MountingHole; M3_hole_with_spacer
