Elektronika-u-Petnici/DC_load/kicad/DC_load/DC_load.kicad_pcb

## KiCad design kicad/DC_load/DC_load.kicad_pcb (continued)

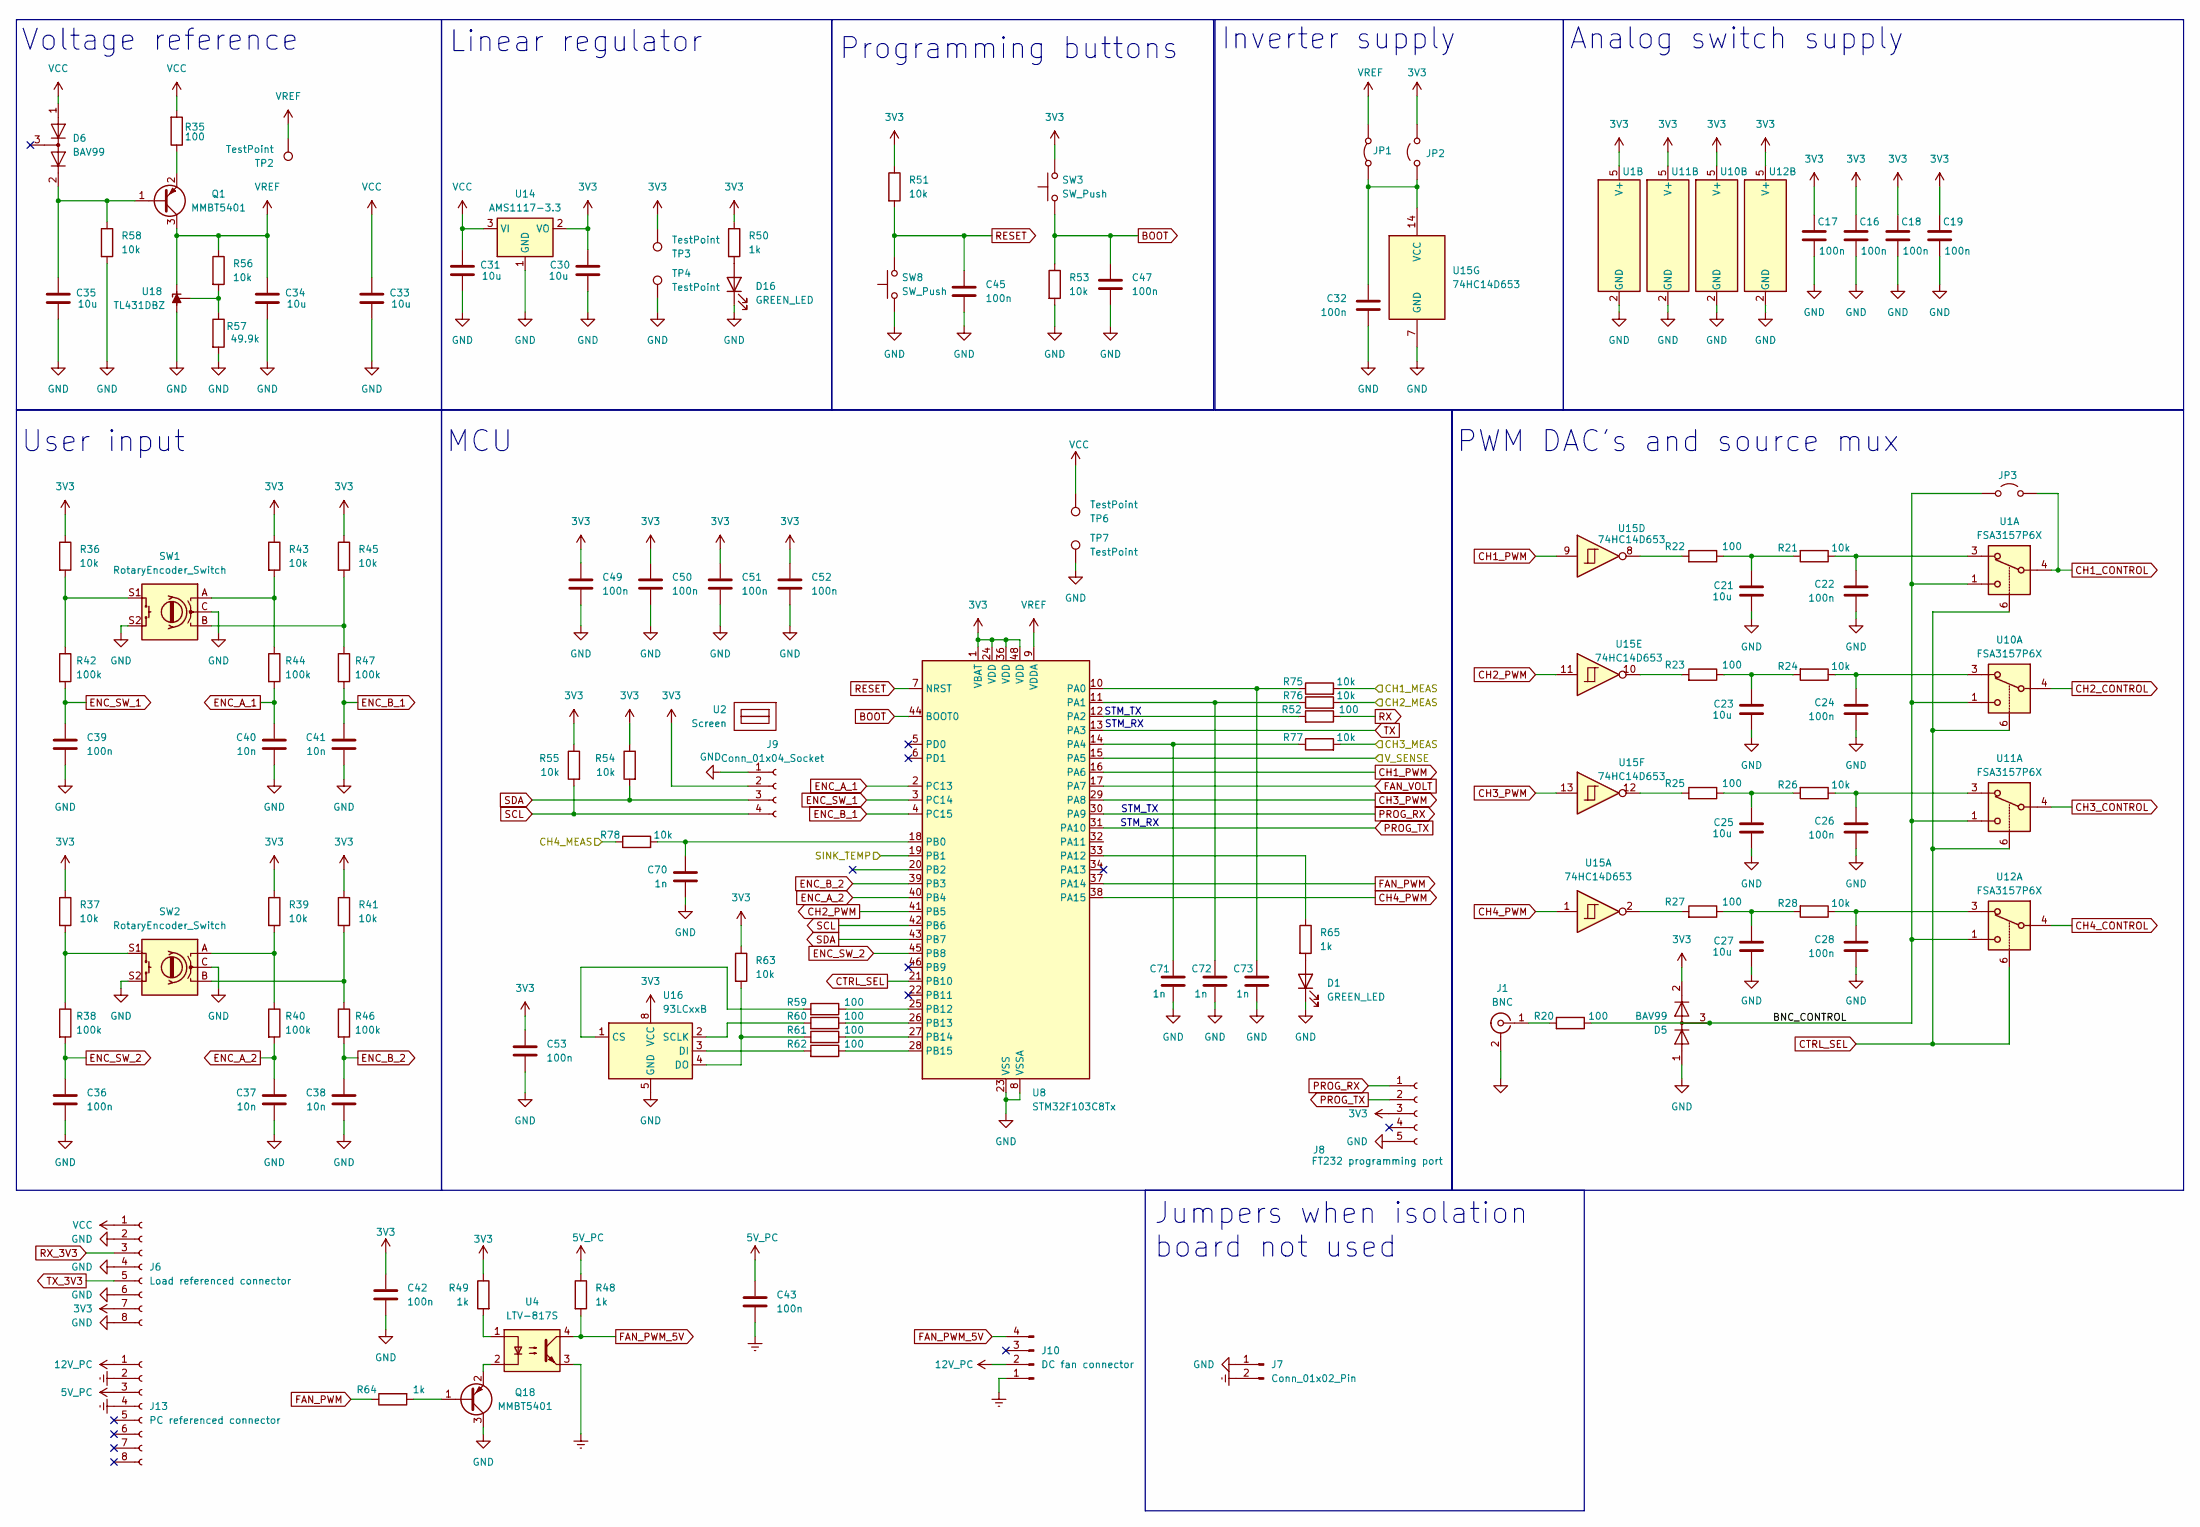
[picture p10: schematic MCU.kicad_sch, MCU sheet]

Parts:
C16, C17, C18, C19, C22, C24, C26, C28, C32, C36, C39, C42, C43, C45, C47, C49, C50, C51, C52, C53: 100n; C_0603_1608Metric_Pad1.08x0.95mm_HandSolder; LCSC C14663
C21, C23, C25, C27, C30, C31, C33, C34, C35: 10u; C_0603_1608Metric_Pad1.08x0.95mm_HandSolder; LCSC C96446
C37, C38, C40, C41: 10n; C_0603_1608Metric_Pad1.08x0.95mm_HandSolder; LCSC C57112
C70, C71, C72, C73: 1n; C_0603_1608Metric_Pad1.08x0.95mm_HandSolder; LCSC C1588
D1, D16: GREEN_LED; LED_0805_2012Metric_Pad1.15x1.40mm_HandSolder; LCSC C2297
D5, D6: BAV99; SOT-23; LCSC C2500
J1: BNC; BNC_Amphenol_B6252HB-NPP3G-50_Horizontal
J6: Load referenced connector; PinHeader_1x08_P2.54mm_Vertical
J7: Conn_01x02_Pin; PinHeader_1x02_P2.54mm_Vertical
J8: FT232 programming port; PinSocket_1x05_P2.54mm_Vertical
J9: Conn_01x04_Socket; PinSocket_1x04_P2.54mm_Vertical
J10: DC fan connector; PinHeader_1x04_P2.54mm_Vertical
J13: PC referenced connector; PinHeader_1x08_P2.54mm_Vertical
JP1: Jumper_2_Bridged; SolderJumper-2_P1.3mm_Bridged_RoundedPad1.0x1.5mm
JP2, JP3: Jumper_2_Open; SolderJumper-2_P1.3mm_Open_RoundedPad1.0x1.5mm
Q1, Q18: MMBT5401; SOT-23; LCSC C8326
R20, R22, R23, R25, R27, R35, R52, R59, R60, R61, R62: 100; R_0603_1608Metric_Pad0.98x0.95mm_HandSolder; LCSC C22775
R21, R24, R26, R28, R36, R37, R39, R41, R43, R45, R51, R53, R54, R55, R56, R58, R63, R75, R76, R77, R78: 10k; R_0603_1608Metric_Pad0.98x0.95mm_HandSolder; LCSC C25804
R38, R40, R42, R44, R46, R47: 100k; R_0603_1608Metric_Pad0.98x0.95mm_HandSolder; LCSC C25803
R48, R49, R64: 1k; R_0603_1608Metric_Pad0.98x0.95mm_HandSolder; LCSC C22962
R50, R65: 1k; R_0603_1608Metric_Pad0.98x0.95mm_HandSolder; LCSC C21190
R57: 49.9k; R_0603_1608Metric_Pad0.98x0.95mm_HandSolder; LCSC C23184
SW1, SW2: RotaryEncoder_Switch; RotaryEncoder_Alps_EC11E-Switch_Vertical_H20mm
SW3, SW8: SW_Push; TS-1088-AR02016; LCSC C720477
TP2, TP3, TP4, TP6, TP7: TestPoint; TestPoint_Pad_D2.0mm
U1, U10, U11, U12: FSA3157P6X; SOT-363_SC-70-6_Handsoldering
U2: Screen; WC1602A - below
U4: LTV-817S; SMDIP-4_W9.53mm
U8: STM32F103C8Tx; LQFP-48_7x7mm_P0.5mm
U14: AMS1117-3.3; SOT-223-3_TabPin2; LCSC C6186
U15: 74HC14D653; SOIC-14_3.9x8.7mm_P1.27mm; LCSC C5605
U16: 93LCxxB; SOIC-8_3.9x4.9mm_P1.27mm
U18: TL431DBZ; SOT-23; LCSC C3113

Connections:
3V3: C16.2, C17.2, C18.2, C19.2, C30.1, C42.2, C49.2, C50.2, C51.2, C52.2, C53.2, D5.2 (A), J6.7, J8.3, J9.2, JP2.2 (B), R36.1, R37.1, R39.1, R41.1, R43.1, R45.1, R49.1, R50.1, R51.1, R54.1, R55.1, R63.1, SW3.2, TP3.1, U1.5 (V+), U8.1 (VBAT), U8.24 (VDD), U8.36 (VDD), U8.48 (VDD), U10.5 (V+), U11.5 (V+), U12.5 (V+), U14.2 (VO), U16.8 (VCC); also elsewhere on the board
5V_PC: C43.2, J13.3, R48.1
12V_PC: J10.2, J13.1
/Microcontroller/BNC_CONTROL: D5.3 (K), JP3.1 (A), R20.1, U1.1, U10.1, U11.1, U12.1
/Microcontroller/CH1_MEAS: R75.2; also elsewhere on the board
/Microcontroller/CH2_MEAS: R76.2; also elsewhere on the board
/Microcontroller/CH3_MEAS: R77.2; also elsewhere on the board
/Microcontroller/CH4_MEAS: R78.1; also elsewhere on the board
/Microcontroller/SINK_TEMP: U8.19 (PB1); also elsewhere on the board
/Microcontroller/V_SENSE: U8.15 (PA5); also elsewhere on the board
BOOT: C47.2, R53.1, SW3.1, U8.44 (BOOT0)
CH1_CONTROL: JP3.2 (B), U1.4; also elsewhere on the board
CH1_PWM: U8.16 (PA6), U15.9
CH2_CONTROL: U10.4; also elsewhere on the board
CH2_PWM: U8.41 (PB5), U15.11
CH3_CONTROL: U11.4; also elsewhere on the board
CH3_PWM: U8.29 (PA8), U15.13
CH4_CONTROL: U12.4; also elsewhere on the board
CH4_PWM: U8.38 (PA15), U15.1
CTRL_SEL: U1.6, U8.21 (PB10), U10.6, U11.6, U12.6
ENC_A_1: C40.2, R44.2, U8.2 (PC13)
ENC_A_2: C37.2, R40.2, U8.40 (PB4)
ENC_B_1: C41.2, R47.2, U8.4 (PC15)
ENC_B_2: C38.2, R46.2, U8.39 (PB3)
ENC_SW_1: C39.2, R42.2, U8.3 (PC14)
ENC_SW_2: C36.2, R38.2, U8.45 (PB8)
Earth: C43.1, J7.2, J10.1, J13.2, J13.4, U4.3
FAN_PWM: R64.1, U8.37 (PA14)
FAN_PWM_5V: J10.4, R48.2, U4.4
FAN_VOLT: U8.17 (PA7)
GND: C16.1, C17.1, C18.1, C19.1, C21.2, C22.1, C23.2, C24.1, C25.2, C26.1, C27.2, C28.1, C30.2, C31.2, C32.1, C33.2, C34.2, C35.2, C36.1, C37.1, C38.1, C39.1, C40.1, C41.1, C42.1, C45.1, C47.1, C49.1, C50.1, C51.1, C52.1, C53.1, C70.1, C71.1, C72.1, C73.1, D1.1 (K), D5.1 (K), D16.1 (K), J1.2 (Ext), J6.2, J6.4, J6.6, J6.8, J7.1, J8.5, J9.1, Q18.3 (C), R53.2, R57.2, R58.2, SW1.C, SW1.S2, SW2.C, SW2.S2, SW8.1, TP4.1, TP7.1, U1.2 (GND), U8.8 (VSSA), U8.23 (VSS), U8.35 (VSS), U8.47 (VSS), U10.2 (GND), U11.2 (GND), U12.2 (GND), U14.1 (GND), U15.7 (GND), U16.5 (GND), U18.3 (A); also elsewhere on the board
unnamed: C21.1, R21.2, R22.1
unnamed: C22.2, R21.1, U1.3
unnamed: C23.1, R23.1, R24.2
unnamed: C24.2, R24.1, U10.3
unnamed: C25.1, R25.1, R26.2
unnamed: C26.2, R26.1, U11.3
unnamed: C27.1, R27.1, R28.2
unnamed: C28.2, R28.1, U12.3
unnamed: D1.2 (A), R65.2
unnamed: C35.1, D6.2 (A), Q1.1 (B), R58.1
unnamed: D16.2 (A), R50.2
unnamed: J1.1 (In), R20.2
unnamed: C32.2, JP1.1 (A), JP2.1 (A), U15.14 (VCC)
unnamed: Q1.2 (E), R35.1
unnamed: Q18.1 (B), R64.2
unnamed: Q18.2 (E), U4.2
unnamed: R22.2, U15.8
unnamed: R23.2, U15.10
unnamed: R25.2, U15.12
unnamed: R27.2, U15.2
unnamed: R36.2, R42.1, SW1.S1
unnamed: R37.2, R38.1, SW2.S1
unnamed: R39.2, R40.1, SW2.A
unnamed: R41.2, R46.1, SW2.B
unnamed: R43.2, R44.1, SW1.A
unnamed: R45.2, R47.1, SW1.B
unnamed: R49.2, U4.1
unnamed: C73.2, R75.1, U8.10 (PA0)
unnamed: C72.2, R76.1, U8.11 (PA1)
unnamed: R52.2, U8.12 (PA2)
unnamed: C71.2, R77.1, U8.14 (PA4)
unnamed: R65.1, U8.33 (PA12)
unnamed: C70.2, R78.2, U8.18 (PB0)
unnamed: R59.1, U8.25 (PB12)
unnamed: R60.1, U8.26 (PB13)
unnamed: R61.1, U8.27 (PB14)
unnamed: R62.1, U8.28 (PB15)
unnamed: R59.2, U16.1 (CS)
unnamed: R62.2, U16.3 (DI)
unnamed: R61.2, R63.2, U16.4 (DO)
unnamed: R60.2, U16.2 (SCLK)
unnamed: R56.2, R57.1, U18.2 (REF)
PROG_RX: J8.1, U8.30 (PA9)
PROG_TX: J8.2, U8.31 (PA10)
RESET: C45.2, R51.2, SW8.2, U8.7 (NRST)
RX: R52.1
RX_3V3: J6.3
SCL: J9.4, R55.2, U8.42 (PB6)
SDA: J9.3, R54.2, U8.43 (PB7)
TX: U8.13 (PA3)
TX_3V3: J6.5
VCC: C31.1, C33.1, D6.1 (K), J6.1, R35.2, TP6.1, U14.3 (VI); also elsewhere on the board
VREF: C34.1, JP1.2 (B), Q1.3 (C), R56.1, TP2.1, U8.9 (VDDA), U18.1 (K)

Notes on the sheet:
STM_RX
STM_TX
Programming buttons
Inverter supply
Jumpers when isolation board not used
PWM DAC's and source mux
Analog switch supply
MCU
Voltage reference
Linear regulator
User input

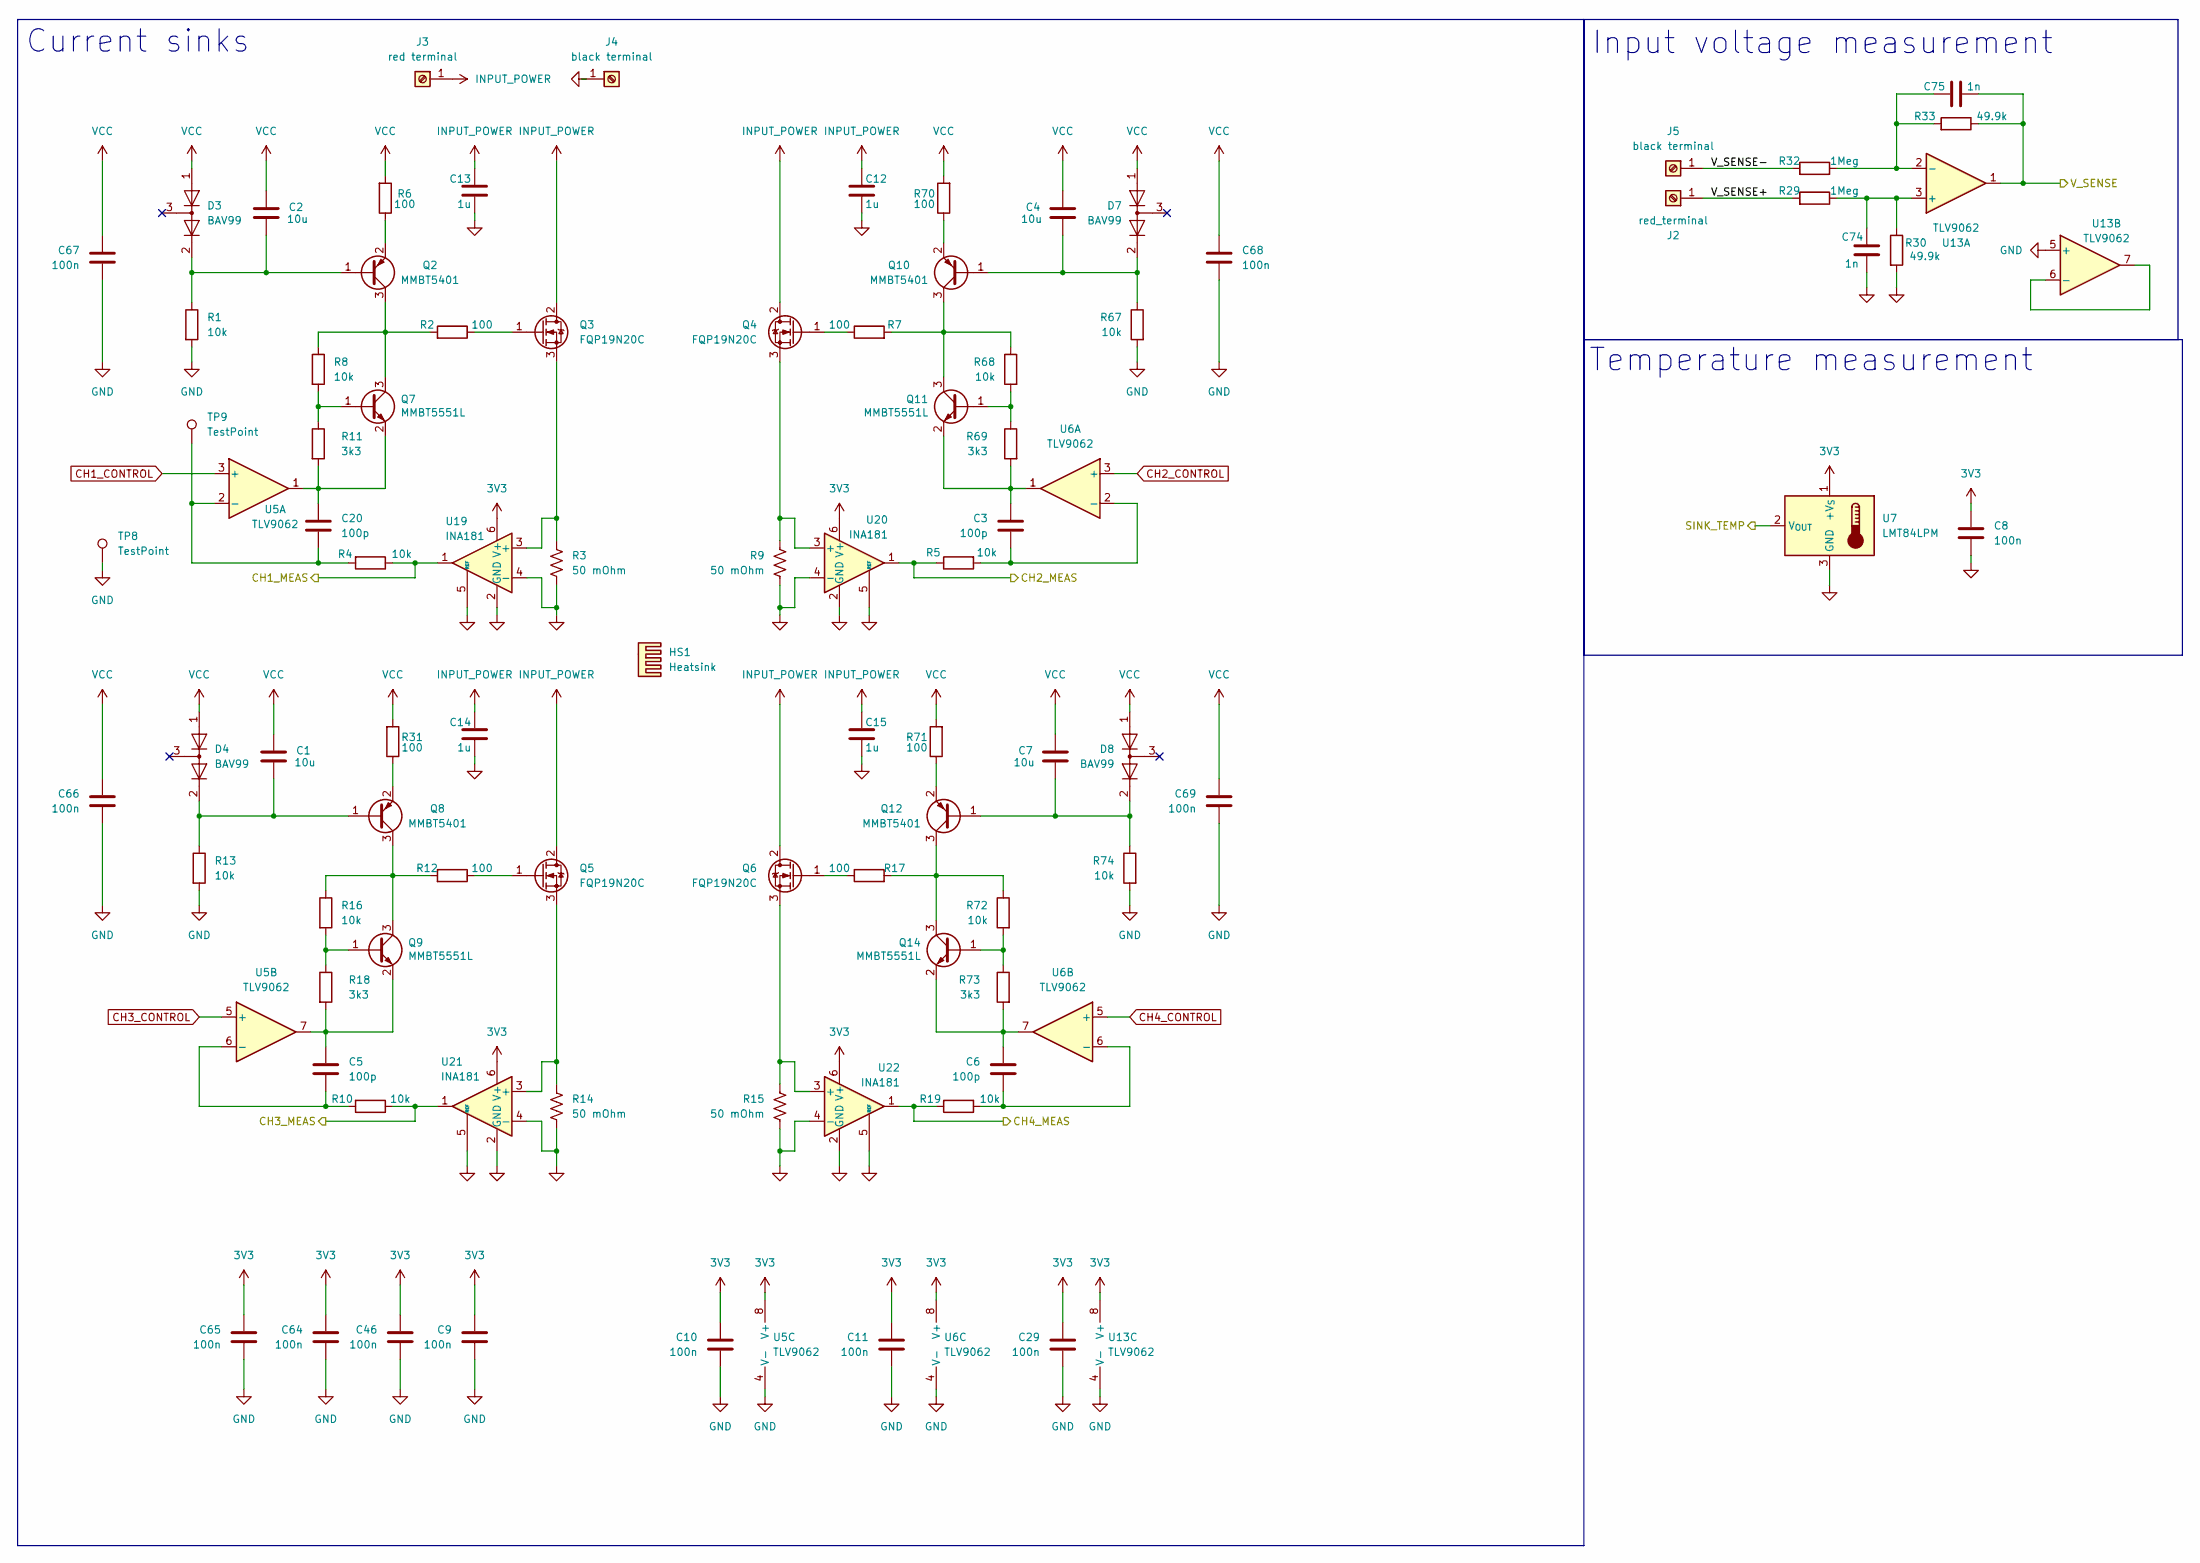
[picture p11: schematic power_stage.kicad_sch, Power stage sheet]

Parts:
C1, C2, C4, C7: 10u; C_0603_1608Metric_Pad1.08x0.95mm_HandSolder; LCSC C96446
C3, C5, C6, C20: 100p; C_0603_1608Metric_Pad1.08x0.95mm_HandSolder; LCSC C14858
C8: 100n; C_0603_1608Metric_Pad1.08x0.95mm_HandSolder
C9, C10, C11, C29, C46, C64, C65, C66, C67, C68, C69: 100n; C_0603_1608Metric_Pad1.08x0.95mm_HandSolder; LCSC C14663
C12, C13, C14, C15: 1u; C_2220_5750Metric_Pad1.97x5.40mm_HandSolder
C74, C75: 1n; C_0603_1608Metric_Pad1.08x0.95mm_HandSolder; LCSC C1588
D3, D4, D7, D8: BAV99; SOT-23; LCSC C2500
HS1: Heatsink; AMD_heatsink
J2: red_terminal; 4mm_terminal_red
J3: red terminal; 4mm_terminal_red
J4, J5: black terminal; 4mm_terminal_black
Q2, Q8, Q10, Q12: MMBT5401; SOT-23; LCSC C8326
Q3, Q4, Q5, Q6: FQP19N20C; TO-220-3_Horizontal_TabUp
Q7, Q9, Q11, Q14: MMBT5551L; SOT-23; LCSC C2145
R1, R4, R5, R8, R10, R13, R16, R19, R67, R68, R72, R74: 10k; R_0603_1608Metric_Pad0.98x0.95mm_HandSolder; LCSC C25804
R2, R6, R7, R12, R17, R31, R70, R71: 100; R_0603_1608Metric_Pad0.98x0.95mm_HandSolder; LCSC C22775
R3, R9, R14, R15: 50 mOhm; R_2512_6332Metric_Pad1.40x3.35mm_HandSolder
R11, R18, R69, R73: 3k3; R_0603_1608Metric_Pad0.98x0.95mm_HandSolder; LCSC C22978
R29, R32: 1Meg; R_0603_1608Metric_Pad0.98x0.95mm_HandSolder; LCSC C22935
R30, R33: 49.9k; R_0603_1608Metric_Pad0.98x0.95mm_HandSolder; LCSC C23184
TP8, TP9: TestPoint; TestPoint_Pad_D2.0mm
U5, U6, U13: TLV9062; SOIC-8_3.9x4.9mm_P1.27mm
U7: LMT84LPM; TO-92_Inline_W4.0mm_Horizontal_FlatSideUp
U19, U20, U21, U22: INA181; SOT-23-6

Connections:
3V3: C8.1, C9.2, C10.2, C11.2, C29.2, C46.2, C64.2, C65.2, U5.8 (V+), U6.8 (V+), U7.1 (+V_{S}), U13.8 (V+), U19.6 (V+), U20.6 (V+), U21.6 (V+), U22.6 (V+); also elsewhere on the board
/Microcontroller/CH1_MEAS: R4.1, U19.1; also elsewhere on the board
/Microcontroller/CH2_MEAS: R5.1, U20.1; also elsewhere on the board
/Microcontroller/CH3_MEAS: R10.1, U21.1; also elsewhere on the board
/Microcontroller/CH4_MEAS: R19.1, U22.1; also elsewhere on the board
/Microcontroller/SINK_TEMP: U7.2 (V_{OUT}); also elsewhere on the board
/Microcontroller/V_SENSE: C75.1, R33.1, U13.1; also elsewhere on the board
/Power_stage/V_SENSE+: J2.1, R29.2
/Power_stage/V_SENSE-: J5.1, R32.2
CH1_CONTROL: U5.3 (+); also elsewhere on the board
CH2_CONTROL: U6.3 (+); also elsewhere on the board
CH3_CONTROL: U5.5 (+); also elsewhere on the board
CH4_CONTROL: U6.5 (+); also elsewhere on the board
GND: C8.2, C9.1, C10.1, C11.1, C12.2, C13.2, C14.2, C15.2, C29.1, C46.1, C64.1, C65.1, C66.1, C67.1, C68.1, C69.1, C74.1, J4.1, R1.2, R3.2, R9.2, R13.2, R14.2, R15.2, R30.2, R67.2, R74.2, TP8.1, U5.4 (V-), U6.4 (V-), U7.3 (GND), U13.4 (V-), U13.5 (+), U19.2 (GND), U19.4 (-), U19.5 (REF), U20.2 (GND), U20.4 (-), U20.5 (REF), U21.2 (GND), U21.4 (-), U21.5 (REF), U22.2 (GND), U22.4 (-), U22.5 (REF); also elsewhere on the board
INPUT_POWER: C12.1, C13.1, C14.1, C15.1, J3.1, Q3.2 (D), Q4.2 (D), Q5.2 (D), Q6.2 (D)
unnamed: C2.2, D3.2 (A), Q2.1 (B), R1.1
unnamed: C1.2, D4.2 (A), Q8.1 (B), R13.1
unnamed: C4.2, D7.2 (A), Q10.1 (B), R67.1
unnamed: C7.2, D8.2 (A), Q12.1 (B), R74.1
unnamed: Q2.3 (C), Q7.3 (C), R2.2, R8.1
unnamed: Q2.2 (E), R6.1
unnamed: Q3.1 (G), R2.1
unnamed: Q3.3 (S), R3.1, U19.3 (+)
unnamed: Q4.1 (G), R7.1
unnamed: Q4.3 (S), R9.1, U20.3 (+)
unnamed: Q5.1 (G), R12.1
unnamed: Q5.3 (S), R14.1, U21.3 (+)
unnamed: Q6.1 (G), R17.1
unnamed: Q6.3 (S), R15.1, U22.3 (+)
unnamed: Q7.1 (B), R8.2, R11.1
unnamed: C20.2, Q7.2 (E), R11.2, U5.1
unnamed: Q8.3 (C), Q9.3 (C), R12.2, R16.1
unnamed: Q8.2 (E), R31.1
unnamed: Q9.1 (B), R16.2, R18.1
unnamed: C5.2, Q9.2 (E), R18.2, U5.7
unnamed: Q10.3 (C), Q11.3 (C), R7.2, R68.1
unnamed: Q10.2 (E), R70.1
unnamed: Q11.1 (B), R68.2, R69.1
unnamed: C3.2, Q11.2 (E), R69.2, U6.1
unnamed: Q12.3 (C), Q14.3 (C), R17.2, R72.1
unnamed: Q12.2 (E), R71.1
unnamed: Q14.1 (B), R72.2, R73.1
unnamed: C6.2, Q14.2 (E), R73.2, U6.7
unnamed: C20.1, R4.2, TP9.1, U5.2 (-)
unnamed: C5.1, R10.2, U5.6 (-)
unnamed: C3.1, R5.2, U6.2 (-)
unnamed: C6.1, R19.2, U6.6 (-)
unnamed: C74.2, R29.1, R30.1, U13.3 (+)
unnamed: C75.2, R32.1, R33.2, U13.2 (-)
unnamed: U13.6 (-), U13.7
VCC: C1.1, C2.1, C4.1, C7.1, C66.2, C67.2, C68.2, C69.2, D3.1 (K), D4.1 (K), D7.1 (K), D8.1 (K), R6.2, R31.2, R70.2, R71.2; also elsewhere on the board

Notes on the sheet:
Input voltage measurement
Current sinks
Temperature measurement

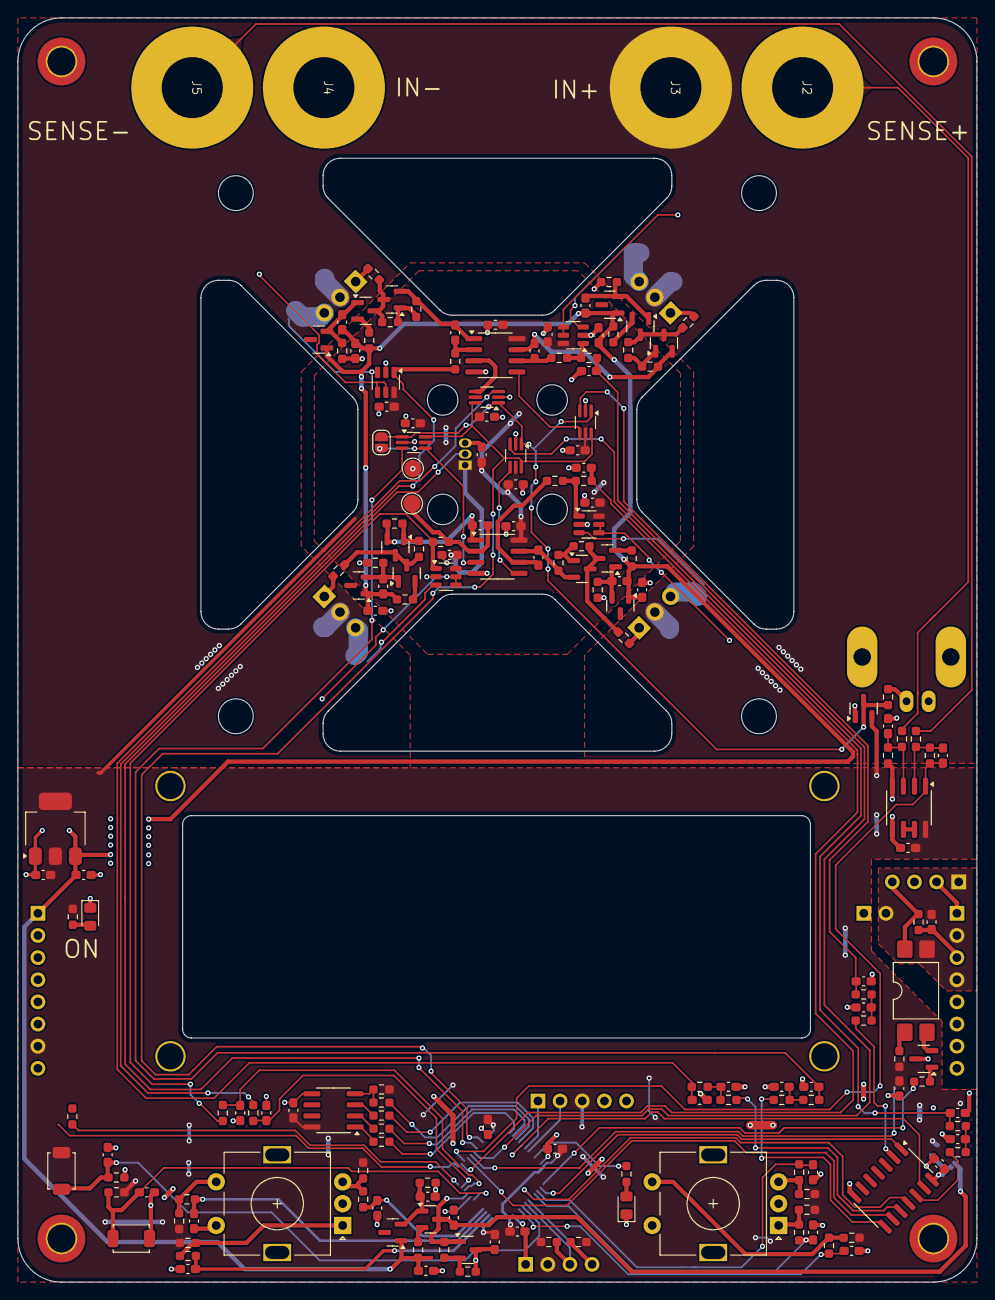
[picture p12: board DC_load.kicad_pcb from above]

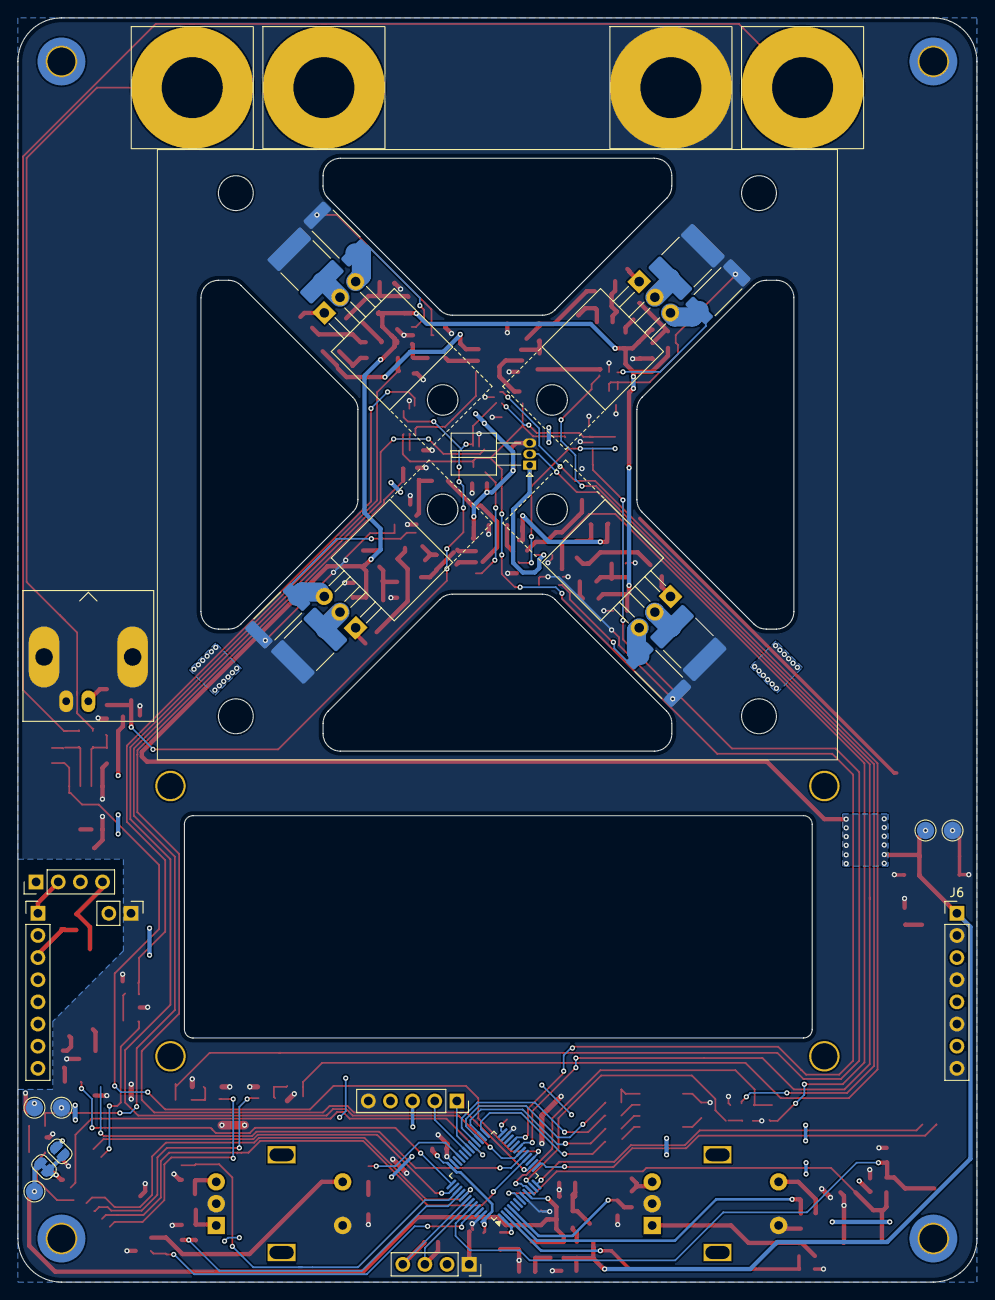
[picture p13: board DC_load.kicad_pcb from below]

Board: 2 copper layers, 110.0 x 145.0 mm, 210 parts (32 on the bottom side), 117 nets.
