Elektronika-u-Petnici/DC_load/(commit log)

2025-11-24 New dimensions.
    [DC_load.kicad_pcb, DC_load.kicad_sch, MCU.kicad_sch, power_stage.kicad_sch]
2025-11-24 Schematic progress.
    [DC_load.kicad_pcb, DC_load.kicad_sch, MCU.kicad_sch, power_stage.kicad_sch]
2025-11-26 Schematic and placement update.
    [DC_load.kicad_pcb, DC_load.kicad_sch, MCU.kicad_sch, power_stage.kicad_sch]
2025-11-26 Added front plate.
    [DC_load.kicad_pcb, DC_load.kicad_sch, DC_load_front_plate.kicad_pcb, DC_load_front_plate.kicad_sch, DC_load_front_plate.step, MCU.kicad_sch, power_stage.kicad_sch]
2025-11-27 Most routing done.
    [DC_load.kicad_pcb, MCU.kicad_sch, power_stage.kicad_sch]
2025-11-27 Added EEPROM
    [DC_load.kicad_pcb, MCU.kicad_sch]
2025-11-27 MCU almost routed.
    [DC_load.kicad_pcb, MCU.kicad_sch]
2025-11-28 Getting closer.
    [DC_load.kicad_pcb]
2025-11-28 No errors.
    [DC_load.kicad_pcb]
2025-11-28 All cool
    [DC_load.kicad_pcb, DC_load.kicad_sch, MCU.kicad_sch, power_stage.kicad_sch]
2025-11-28 Added voltage sense
    [DC_load.kicad_pcb, DC_load.kicad_sch, MCU.kicad_sch, power_stage.kicad_sch]
2025-11-28 Fan black now.
    [DC_load.kicad_pcb]
2025-11-30 DC fan boost converter added.
    [DC_load.kicad_pcb, DC_load.kicad_sch, MCU.kicad_sch]
2025-11-30 No errors, fan added.
    [DC_load.kicad_pcb]
2025-11-30 Review left.
    [DC_load.kicad_pcb]
2025-11-30 Added jumper.
    [DC_load.kicad_pcb, MCU.kicad_sch]
2025-11-30 More agresive PWM filtering.
    [DC_load.kicad_pcb, MCU.kicad_sch]
2025-12-01 Vbe multiplier, constant current source 12V mosfet gate driver. RC filters moved lower. INA181 for 20x gain, 50 mOhm shunts. Jumper moved to BNC. Rough placement initiated.
    [DC_load.kicad_pcb, MCU.kicad_sch, power_stage.kicad_sch]
2025-12-01 Još gate driver layout.
    [DC_load.kicad_pcb, MCU.kicad_sch, power_stage.kicad_sch]
2025-12-02 RC filter na ADC linijama Placement update.
    [DC_load.kicad_pcb, MCU.kicad_sch]
2025-12-02 Ready for production.
    [DC_load.kicad_pcb, DC_load.kicad_sch, MCU.kicad_sch, power_stage.kicad_sch]
2025-12-04 Galvanic isolation for the UART.
    [DC_load.kicad_pcb, DC_load_isolation_module.kicad_pcb, DC_load_isolation_module.kicad_sch, MCU.kicad_sch, bom.csv, designators.csv, positions.csv, power_stage.kicad_sch]
2025-12-07 MC to 12V -> halfbridge to rest.
2025-12-08 Sim, comp, power.
    [DC_load.kicad_pcb, DC_load.kicad_sch, DC_load_isolation_module.kicad_sch, MCU.kicad_sch, isolated_logic.kicad_sch, isolated_supply.kicad_sch]
2025-12-10 Schematic done.
    [DC_load.kicad_pcb, DC_load_isolation_module.kicad_pcb, MCU.kicad_sch, boost.kicad_sch, isolated_logic.kicad_sch, isolated_supply.kicad_sch, power_stage.kicad_sch]
2025-12-11 Some placement.
    [DC_load_isolation_module.kicad_pcb, isolated_supply.kicad_sch]
2025-12-17 Replaced switches with JLCPCB basic.
    [DC_load.kicad_pcb, MCU.kicad_sch]
2025-12-17 Schem Schem.
    [DC_load.kicad_sch, MCU.kicad_sch]
2025-12-24 SRF sch.
    [DC_load_isolation_module.kicad_pcb, DC_load_isolation_module.kicad_sch, isolated_supply.kicad_sch, srf.kicad_sch]
2025-12-24 SRF layout
    [DC_load_isolation_module.kicad_pcb, DC_load_isolation_module.kicad_sch, isolated_logic.kicad_sch]
2025-12-28 Working on layout.
    [DC_load_isolation_module.kicad_pcb, boost.kicad_sch, isolated_logic.kicad_sch, isolated_supply.kicad_sch, srf.kicad_sch]
2026-01-10 Connectors fixed.
    [DC_load.kicad_pcb, DC_load_isolation_module.kicad_pcb, DC_load_isolation_module.kicad_sch, MCU.kicad_sch, boost.kicad_sch, isolated_logic.kicad_sch, isolated_supply.kicad_sch, srf.kicad_sch]
2026-01-11 Tiny update.
    [DC_load.kicad_pcb, MCU.kicad_sch]
2026-01-11 Main board close to done.
    [DC_load.kicad_pcb, MCU.kicad_sch]
2026-01-11 Iso module almost done.
    [DC_load_isolation_module.kicad_pcb, DC_load_isolation_module.kicad_sch]
2026-01-17 pre prod
    [DC_load_isolation_module.kicad_pcb, bom.csv, designators.csv, positions.csv]
